mattbrejza/cubesat-comms/testing/pa/b.png

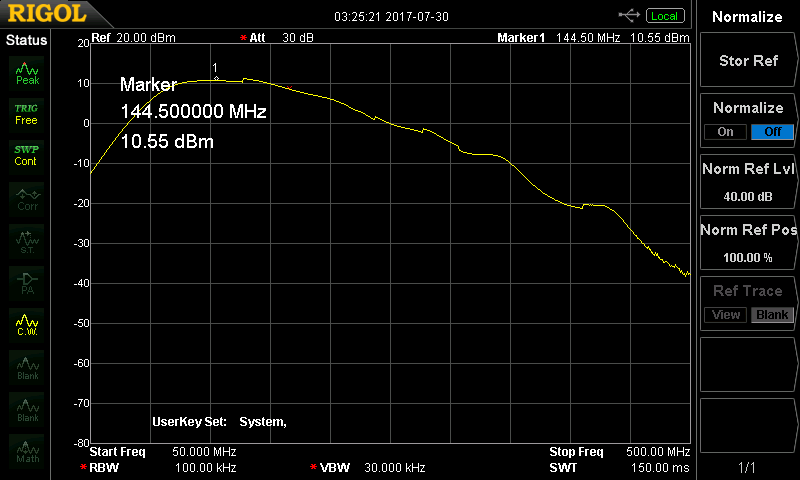
testing/pa/b.png
