mattbrejza/cubesat-comms/testing/pa/r.png

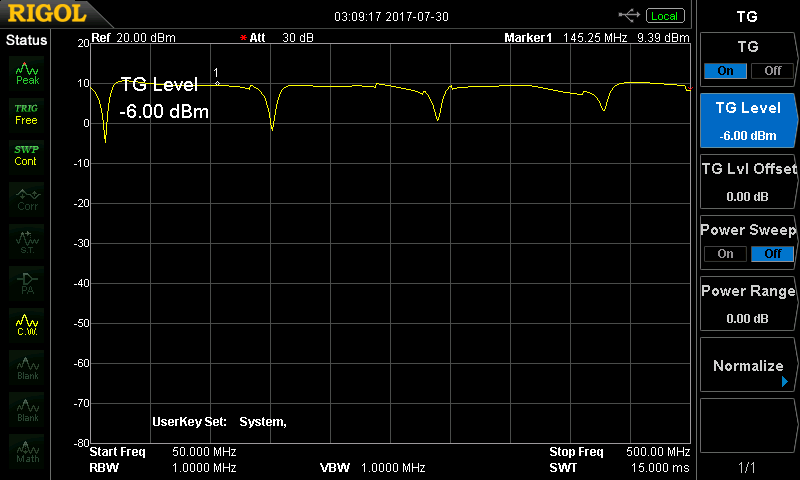
testing/pa/r.png
