mattbrejza/cubesat-comms/testing/pa/tek00002.png

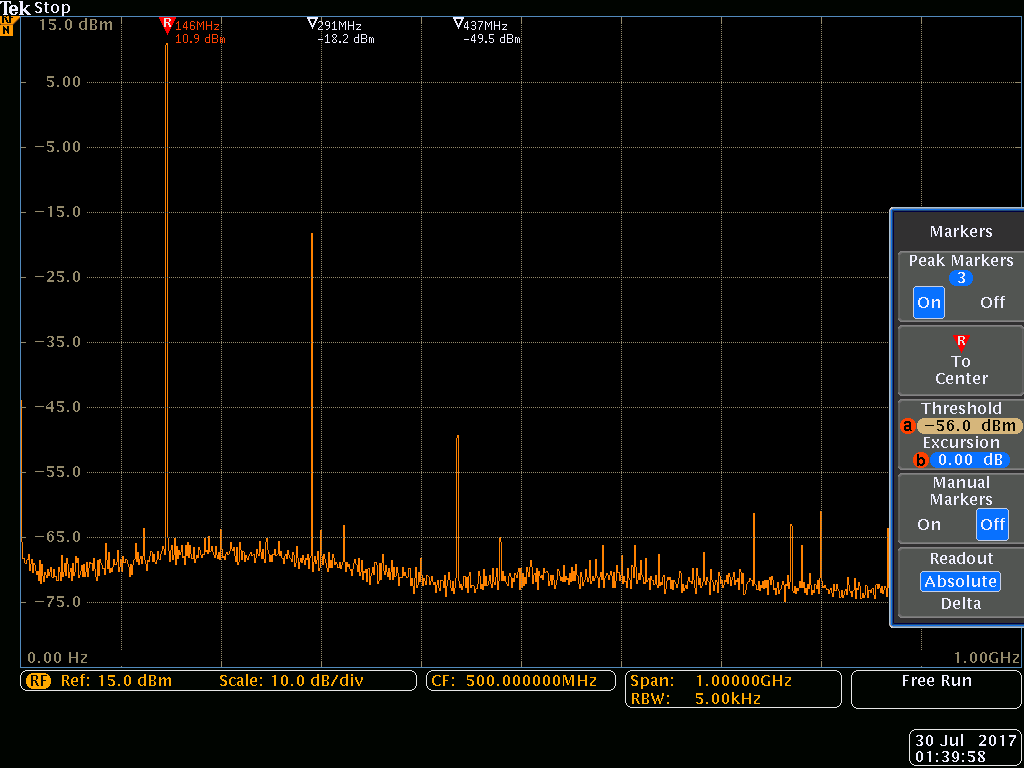
testing/pa/tek00002.png
