mattbrejza/cubesat-comms/testing/pa/tek00003.png

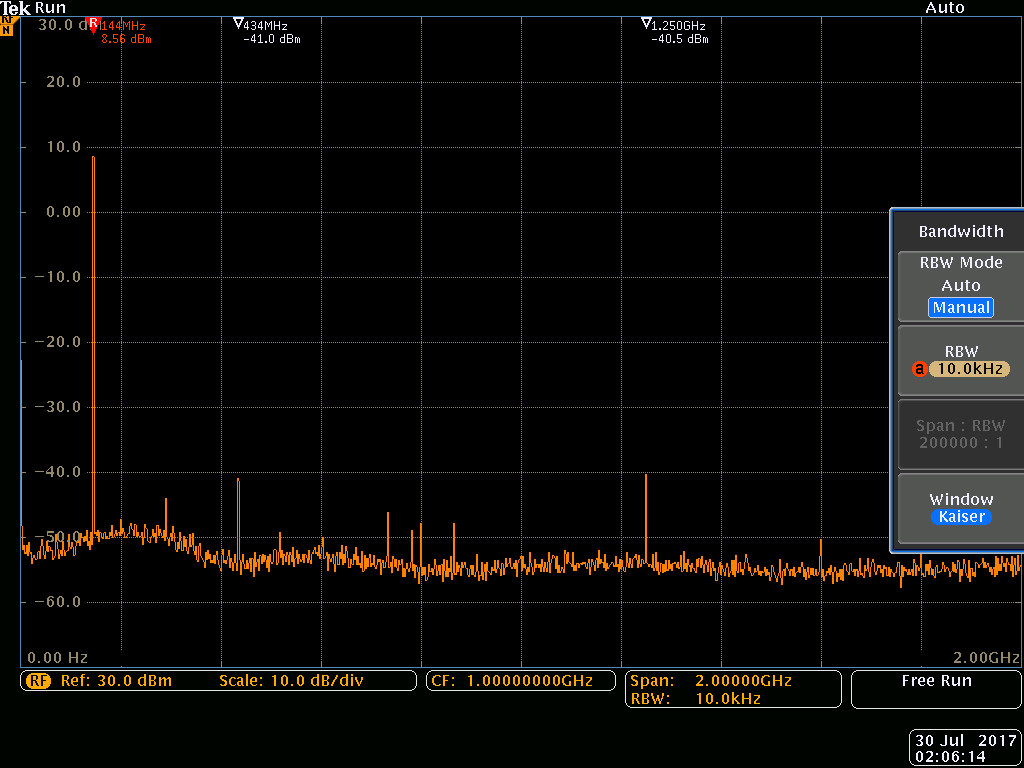
testing/pa/tek00003.png
