mattbrejza/cubesat-comms/testing/pa/tek00004.png

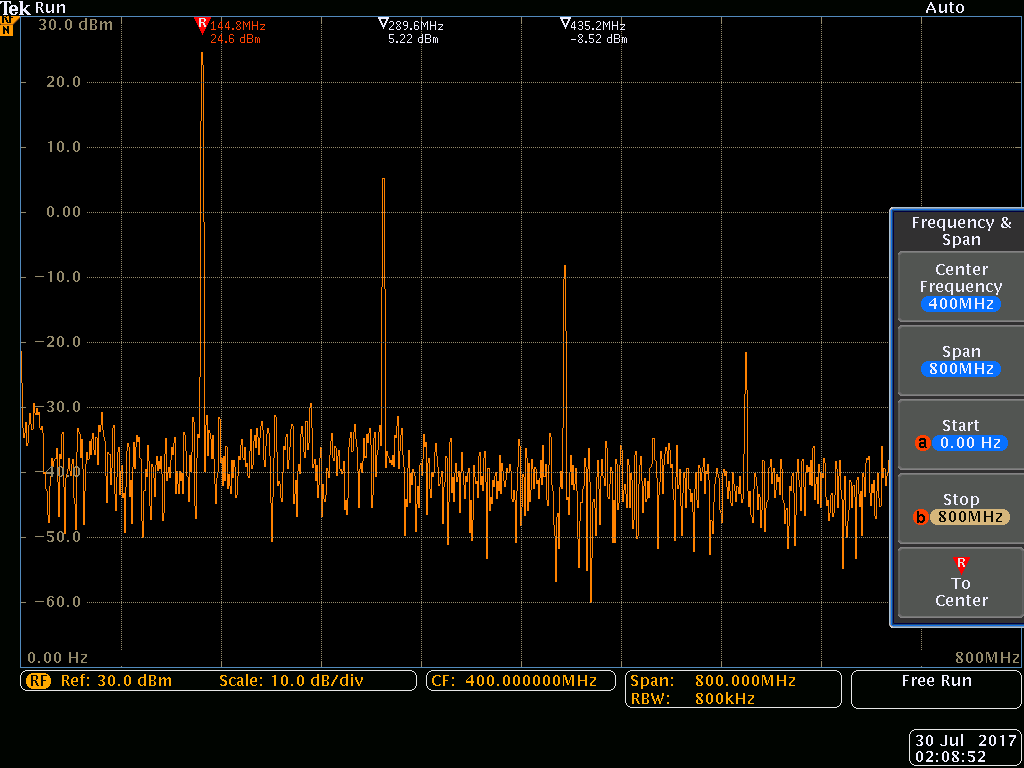
testing/pa/tek00004.png
