mattbrejza/cubesat-comms/testing/pa/tek00005.png

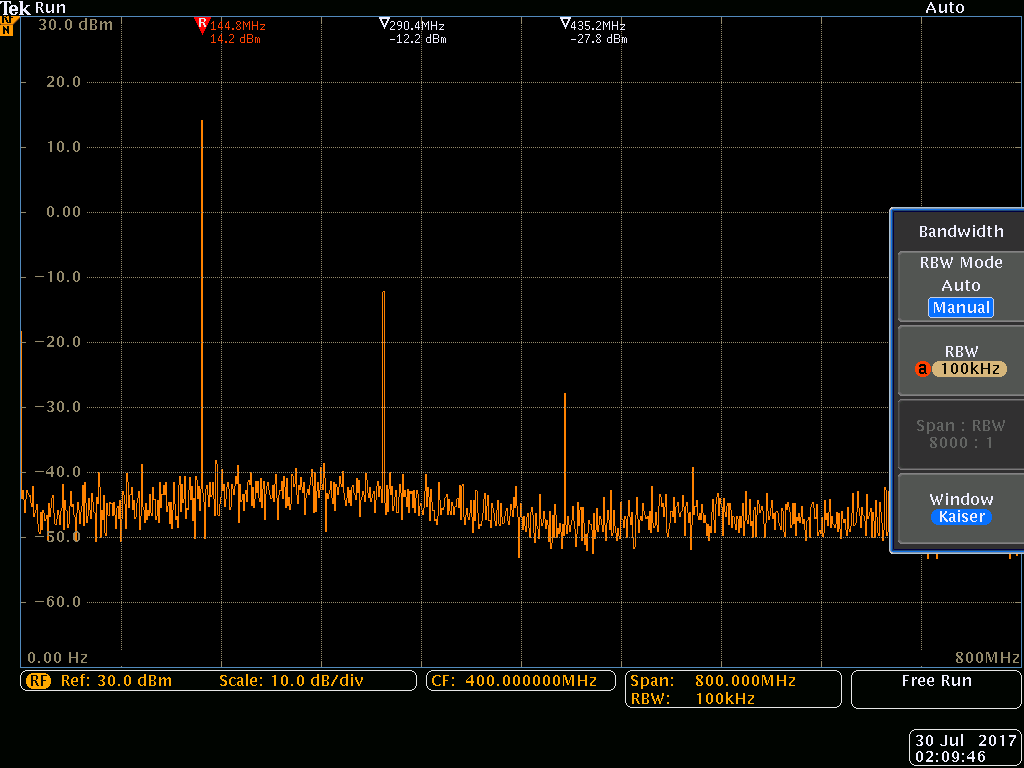
testing/pa/tek00005.png
