mattbrejza/cubesat-comms/testing/pa/tek00006.png

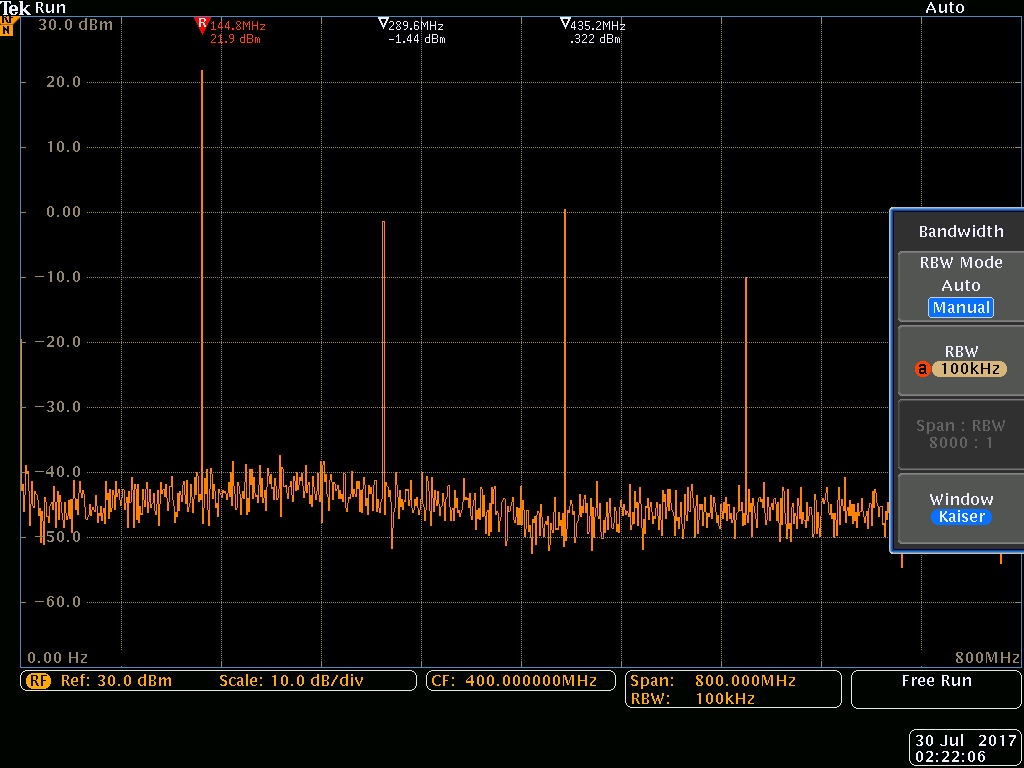
testing/pa/tek00006.png
