mattbrejza/cubesat-comms/testing/pa/tek00007.png

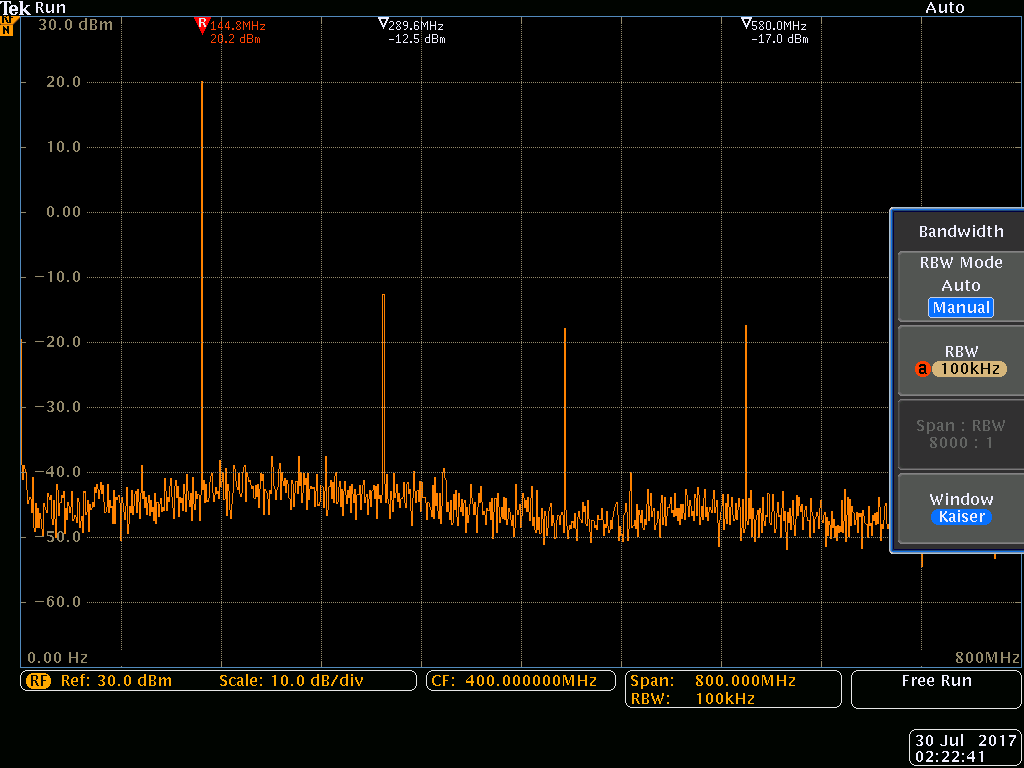
testing/pa/tek00007.png
