mattbrejza/cubesat-comms/testing/pa/w.png

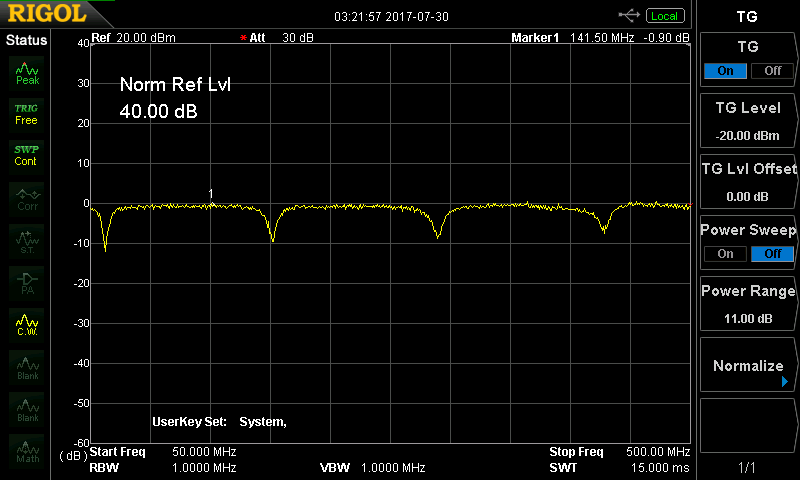
testing/pa/w.png
