mattbrejza/cubesat-comms/paper-fig.pdf

# Supervisor circuit

5V

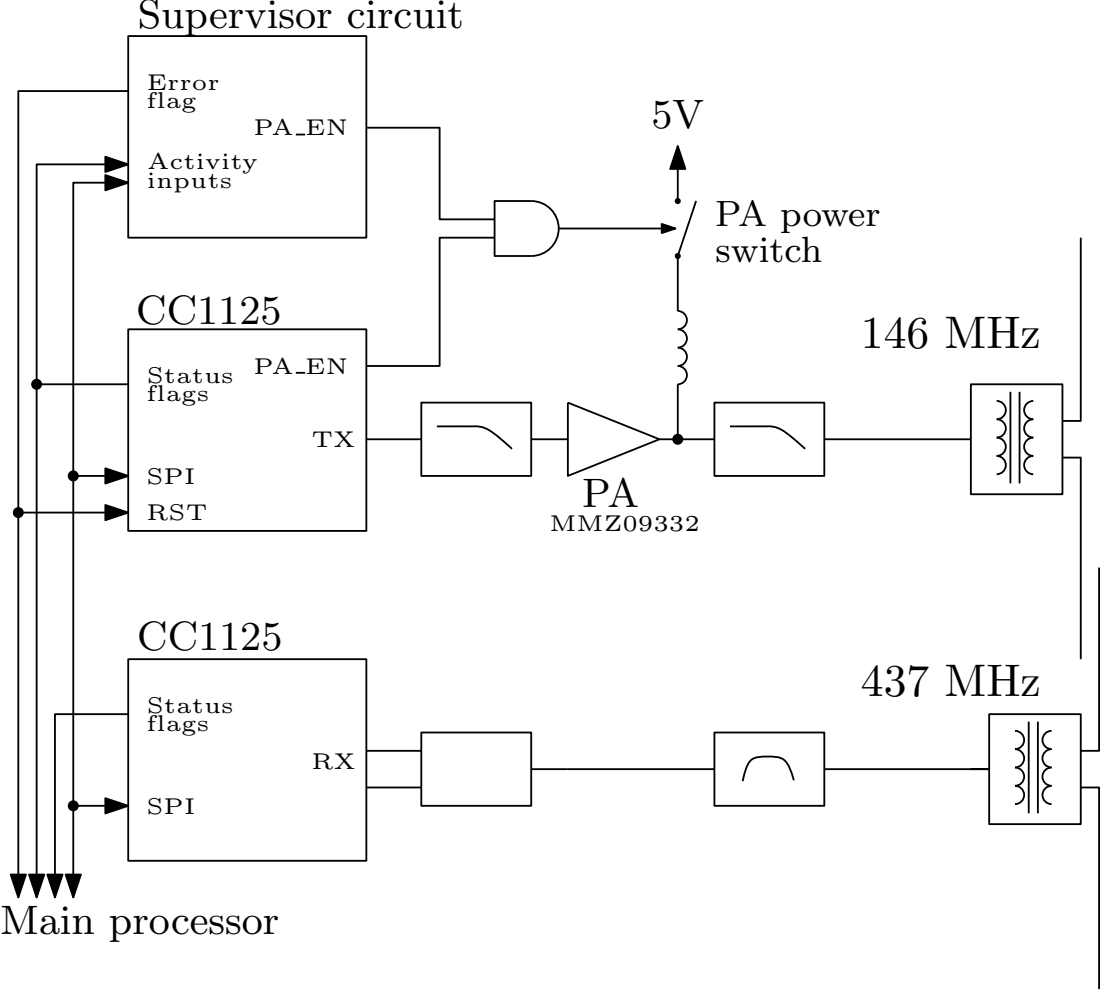
[picture p10: page 1]
146 MHz; 437 MHz; SPI; MMZ09332; Status flags; Error flag; Activity inputs; PA power switch; Main processor; RST
