mattbrejza/cubesat-comms/board-fc-cm/fc-comms-2.brd

## EAGLE design board-fc-cm/fc-comms-2.brd (2018-10-24)

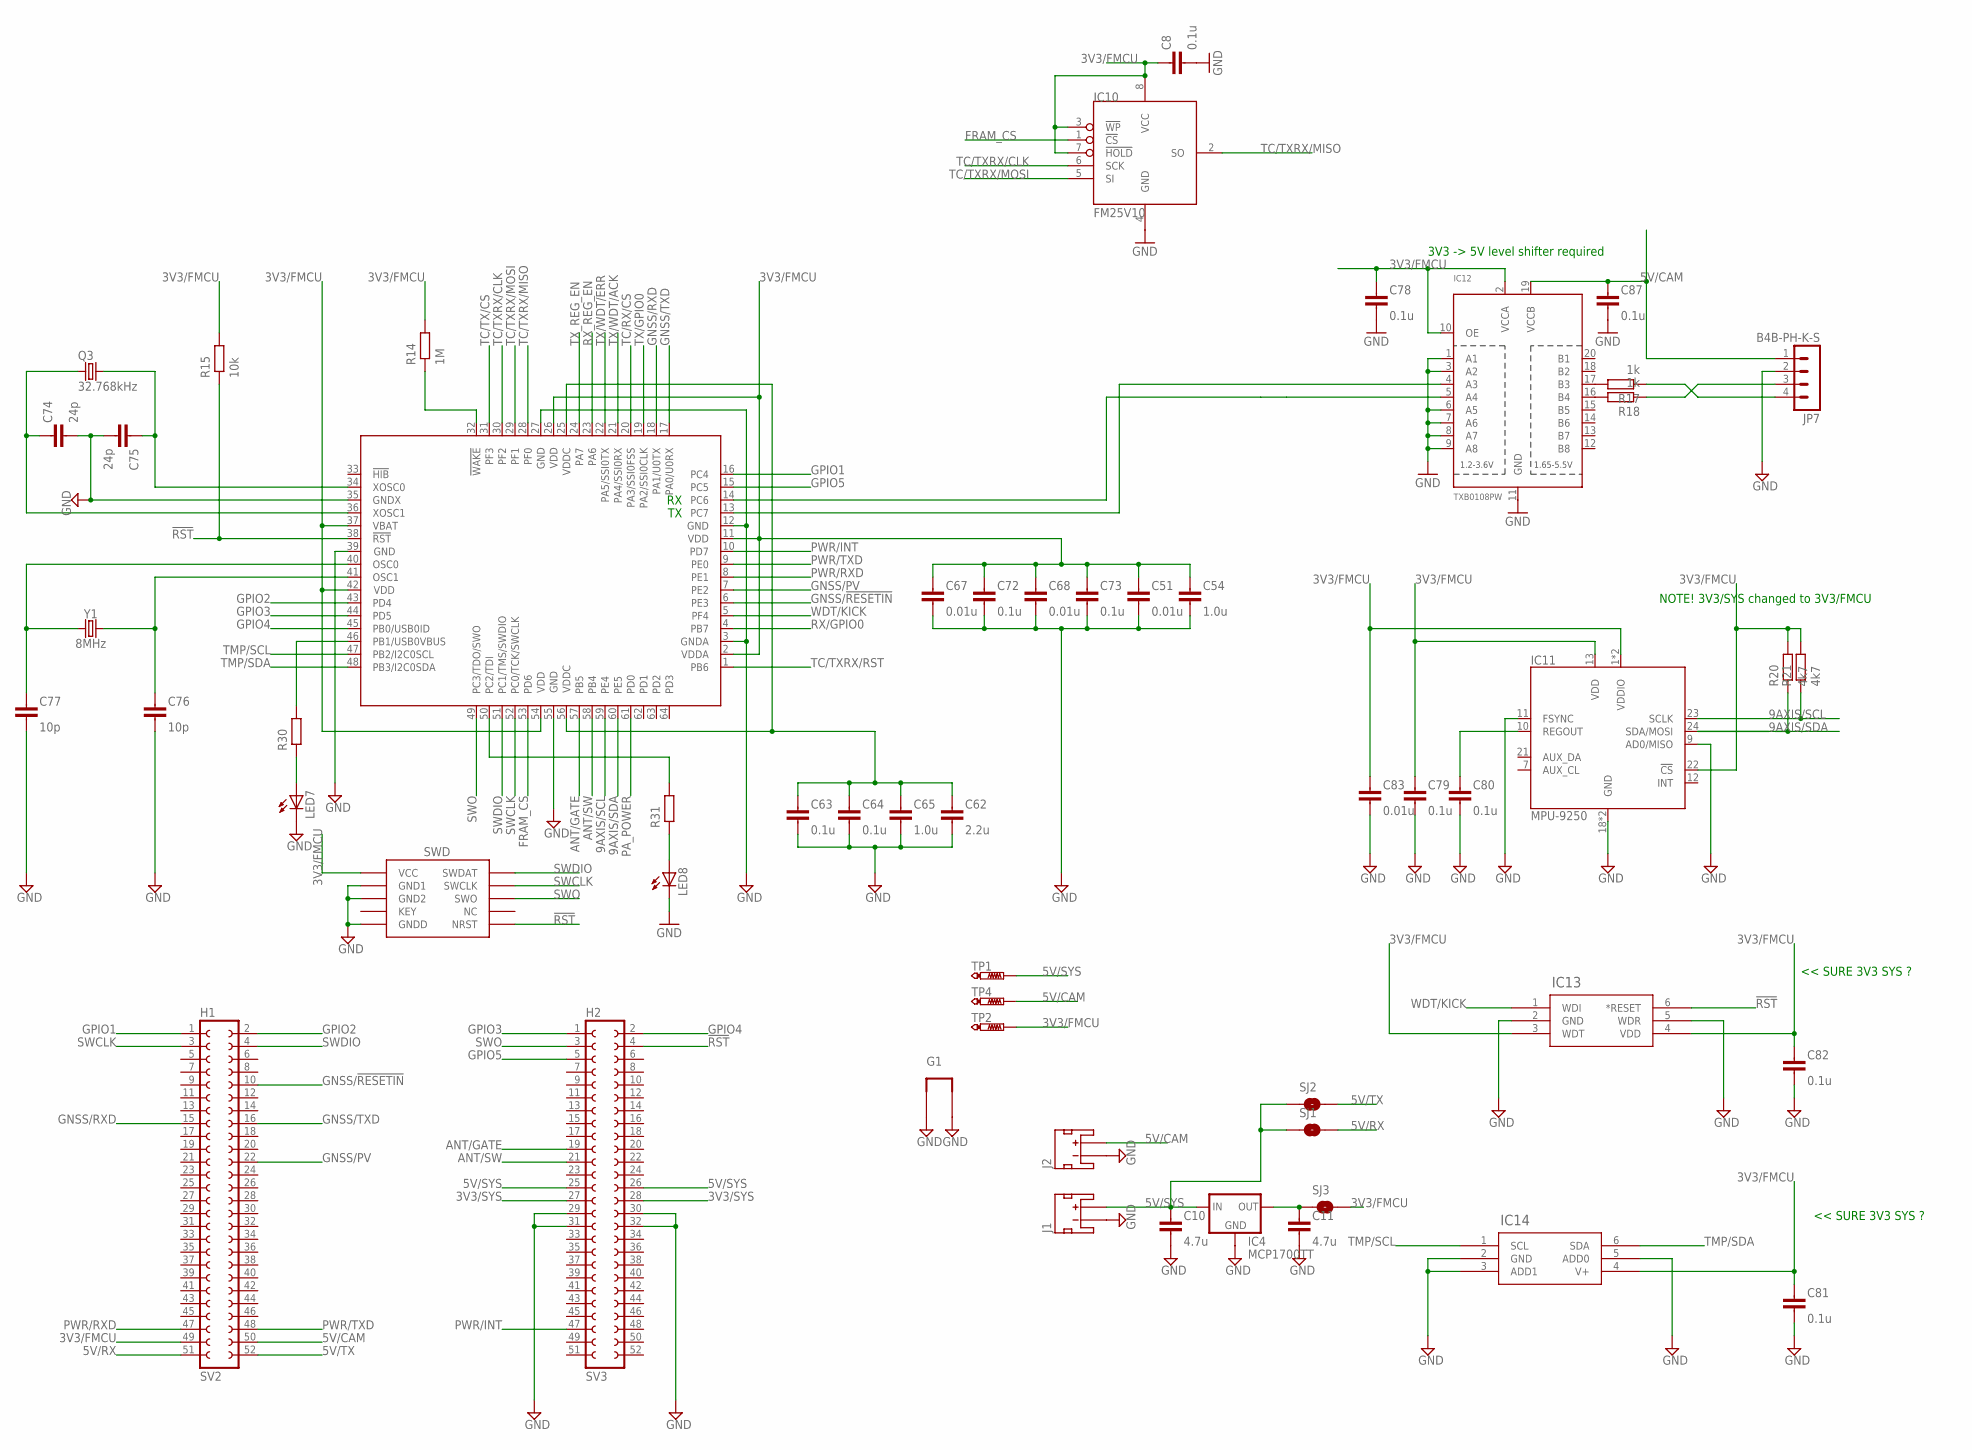
[picture p11: schematic fc-comms-2.sch, sheet 1]

Parts:
C8, C63, C64, C72, C73, C78, C79, C80, C81, C82, C87: 0.1u; C0603-N
C10, C11: 4.7u; C0603-N
C51, C67, C68, C83: 0.01u; C0603-N
C54, C65: 1.0u; C0603-N
C62: 2.2u; C0603-N
C74, C75: 24p; C0603-N
C76, C77: 10p; C0603-N
G1: GND-LOOPL; GND-LOOP-0.4
IC4: MCP1700TT; SOT23
IC9: TM4C123[7,G]XXPM; PM_S-PQFP-G64
IC10: FM25V10; SO-08M
IC11: MPU-9250; QFN-24/3MM
IC12: TXB0108PW; TSSOP20
IC13: TPS3813K33-EP_DBV_6; DBV6
IC14: TMP100-EP_DBV_6; DBV6
J1, J2: JST_2MM_MALE_TH; JST-2-TH
J3: SWD_SHROUD; SWD_PTH_SHROUD
JP7: B4B-PH-K-S
LED7, LED8: LEDCHIP-LED0603; CHIP-LED0603
Q3: 32.768kHz; RESONATOR_EPSON_FC_145; FARNELL 2101347
R14: 1M; R0603-N
R15: 10k; R0603-N
R17, R18: 1k; R0603-N
R20, R21: 4k7; R0603-N
R30, R31: RESISTOR0603-N; R0603-N
SJ1, SJ2, SJ3: JUMPER-PAD-2-NOYES_SILK; PAD-JUMPER-2-NO_YES_SILK
SV2: H1; FE26-2
SV3: H2; FE26-2
TP1, TP2, TP4: PTR1PAD1-13; P1-13
Y1: 8MHz; CRYSTAL-SMD-5X3.2-4PAD; FARNELL 2308726

Connections:
3V3/FMCU: C8.1, C51.1, C54.1, C67.1, C68.1, C72.1, C73.1, C78.1, C79.1, C81.1, C82.1, C83.1, IC9.2 (VDDA), IC9.11 (VDD), IC9.26 (VDD), IC9.37 (VBAT), IC9.42 (VDD), IC9.54 (VDD), IC10.3 (!WP), IC10.7 (!HOLD), IC10.8 (VCC), IC11.1 (VDDIO), IC11.8 (VDDIO), IC11.13 (VDD), IC11.22 (!CS), IC12.2 (VCCA), IC12.10 (OE), IC13.3 (WDT), IC13.4 (VDD), IC14.4 (V+), J3.1 (VCC), R14.2, R15.2, R20.2, R21.2, SJ3.2, SV2.49, TP2.TP; also elsewhere on the board
3V3/SYS: SV3.27, SV3.28
5V/CAM: C87.1, IC12.19 (VCCB), J2.1 (+), JP7.1, SV2.50, TP4.TP
5V/RX: SJ1.2, SV2.51; also elsewhere on the board
5V/SYS: C10.1, IC4.3 (IN), J1.1 (+), SJ1.1, SJ2.1, SV3.25, SV3.26, TP1.TP
5V/TX: SJ2.2, SV2.52; also elsewhere on the board
9AXIS/SCL: IC9.59 (PE4), IC11.23 (SCLK), R21.1
9AXIS/SDA: IC9.60 (PE5), IC11.24 (SDA/MOSI), R20.1
!RST: IC9.38 (!RST), IC13.6 (*RESET), J3.10 (NRST), R15.1, SV3.4
!WAKE: IC9.32 (!WAKE), R14.1
ANT/GATE: IC9.57 (PB5), SV3.19
ANT/SW: IC9.58 (PB4), SV3.21
CAM/RXD: IC9.13 (PC7), IC12.4 (A3)
CAM/TXD: IC9.14 (PC6), IC12.5 (A4)
FRAM_CS: IC9.53 (PD6), IC10.1 (!CS)
GND: C8.2, C10.2, C11.2, C51.2, C54.2, C62.2, C63.2, C64.2, C65.2, C67.2, C68.2, C72.2, C73.2, C74.2, C75.2, C76.2, C77.2, C78.2, C79.2, C80.2, C81.2, C82.2, C83.2, C87.2, G1.P$3 (1), G1.P$4 (2), IC4.1 (GND), IC9.3 (GNDA), IC9.12 (GND), IC9.27 (GND), IC9.35 (GNDX), IC9.39 (GND), IC9.55 (GND), IC10.4 (GND), IC11.9 (AD0/MISO), IC11.11 (FSYNC), IC11.18 (GND), IC11.20 (GND), IC12.1 (A1), IC12.3 (A2), IC12.6 (A5), IC12.7 (A6), IC12.8 (A7), IC12.9 (A8), IC12.11 (GND), IC13.2 (GND), IC13.5 (WDR), IC14.2 (GND), IC14.3 (ADD1), IC14.5 (ADD0), J1.2 (-), J2.2 (-), J3.3 (GND1), J3.5 (GND2), J3.9 (GNDD), JP7.2, LED7.C, LED8.C, SV3.29, SV3.30, SV3.31, SV3.32; also elsewhere on the board
GNSS/!RESETIN: IC9.6 (PE3), SV2.10
GNSS/PV: IC9.7 (PE2), SV2.22
GNSS/RXD: IC9.18 (PA1/U0TX), SV2.15
GNSS/TXD: IC9.17 (PA0/U0RX), SV2.16
GPIO1: IC9.16 (PC4), SV2.1
GPIO2: IC9.43 (PD4), SV2.2
GPIO3: IC9.44 (PD5), SV3.1
GPIO4: IC9.45 (PB0/USB0ID), SV3.2
GPIO5: IC9.15 (PC5), SV3.5
unnamed: C80.1, IC11.10 (REGOUT)
unnamed: C62.1, C63.1, C64.1, C65.1, IC9.25 (VDDC), IC9.56 (VDDC)
unnamed: C75.1, IC9.34 (XOSC0), Q3.P$2 (2)
unnamed: C77.1, IC9.40 (OSC0), Y1.1
unnamed: JP7.3, R18.1
unnamed: JP7.4, R17.1
unnamed: C76.1, IC9.41 (OSC1), Y1.3 (2)
unnamed: C74.1, IC9.36 (XOSC1), Q3.P$1 (1)
unnamed: LED7.A, R30.1
unnamed: LED8.A, R31.1
unnamed: IC9.50 (PC2/TDI), R31.2
unnamed: IC12.17 (B3), R17.2
unnamed: IC9.46 (PB1/USB0VBUS), R30.2
unnamed: IC12.16 (B4), R18.2
unnamed: C11.1, IC4.2 (OUT), SJ3.1
PA_POWER: IC9.61 (PD0); also elsewhere on the board
PWR/INT: IC9.10 (PD7), SV3.47
PWR/RXD: IC9.8 (PE1), SV2.47
PWR/TXD: IC9.9 (PE0), SV2.48
RX/GPIO0: IC9.4 (PB7); also elsewhere on the board
RX_REG_EN: IC9.23 (PA6); also elsewhere on the board
SWCLK: IC9.52 (PC0/TCK/SWCLK), J3.4 (SWCLK), SV2.3
SWDIO: IC9.51 (PC1/TMS/SWDIO), J3.2 (SWDAT), SV2.4
SWO: IC9.49 (PC3/TDO/SWO), J3.6 (SWO), SV3.3
TC/RX/CS: IC9.20 (PA3/SSI0FSS); also elsewhere on the board
TC/TX/CS: IC9.31 (PF3); also elsewhere on the board
TC/TXRX/CLK: IC9.30 (PF2), IC10.6 (SCK); also elsewhere on the board
TC/TXRX/MISO: IC9.28 (PF0), IC10.2 (SO); also elsewhere on the board
TC/TXRX/MOSI: IC9.29 (PF1), IC10.5 (SI); also elsewhere on the board
TC/TXRX/RST: IC9.1 (PB6); also elsewhere on the board
TMP/SCL: IC9.47 (PB2/I2C0SCL), IC14.1 (SCL); also elsewhere on the board
TMP/SDA: IC9.48 (PB3/I2C0SDA), IC14.6 (SDA); also elsewhere on the board
TX/GPIO0: IC9.19 (PA2/SSI0CLK); also elsewhere on the board
TX/WDT/ACK: IC9.21 (PA4/SSI0RX); also elsewhere on the board
TX/WDT/ERR: IC9.22 (PA5/SSI0TX); also elsewhere on the board
TX_REG_EN: IC9.24 (PA7); also elsewhere on the board
WDT/KICK: IC9.5 (PF4), IC13.1 (WDI)

Notes on the sheet:
3V3 -> 5V level shifter required
<< SURE 3V3 SYS ?
NOTE! 3V3/SYS changed to 3V3/FMCU

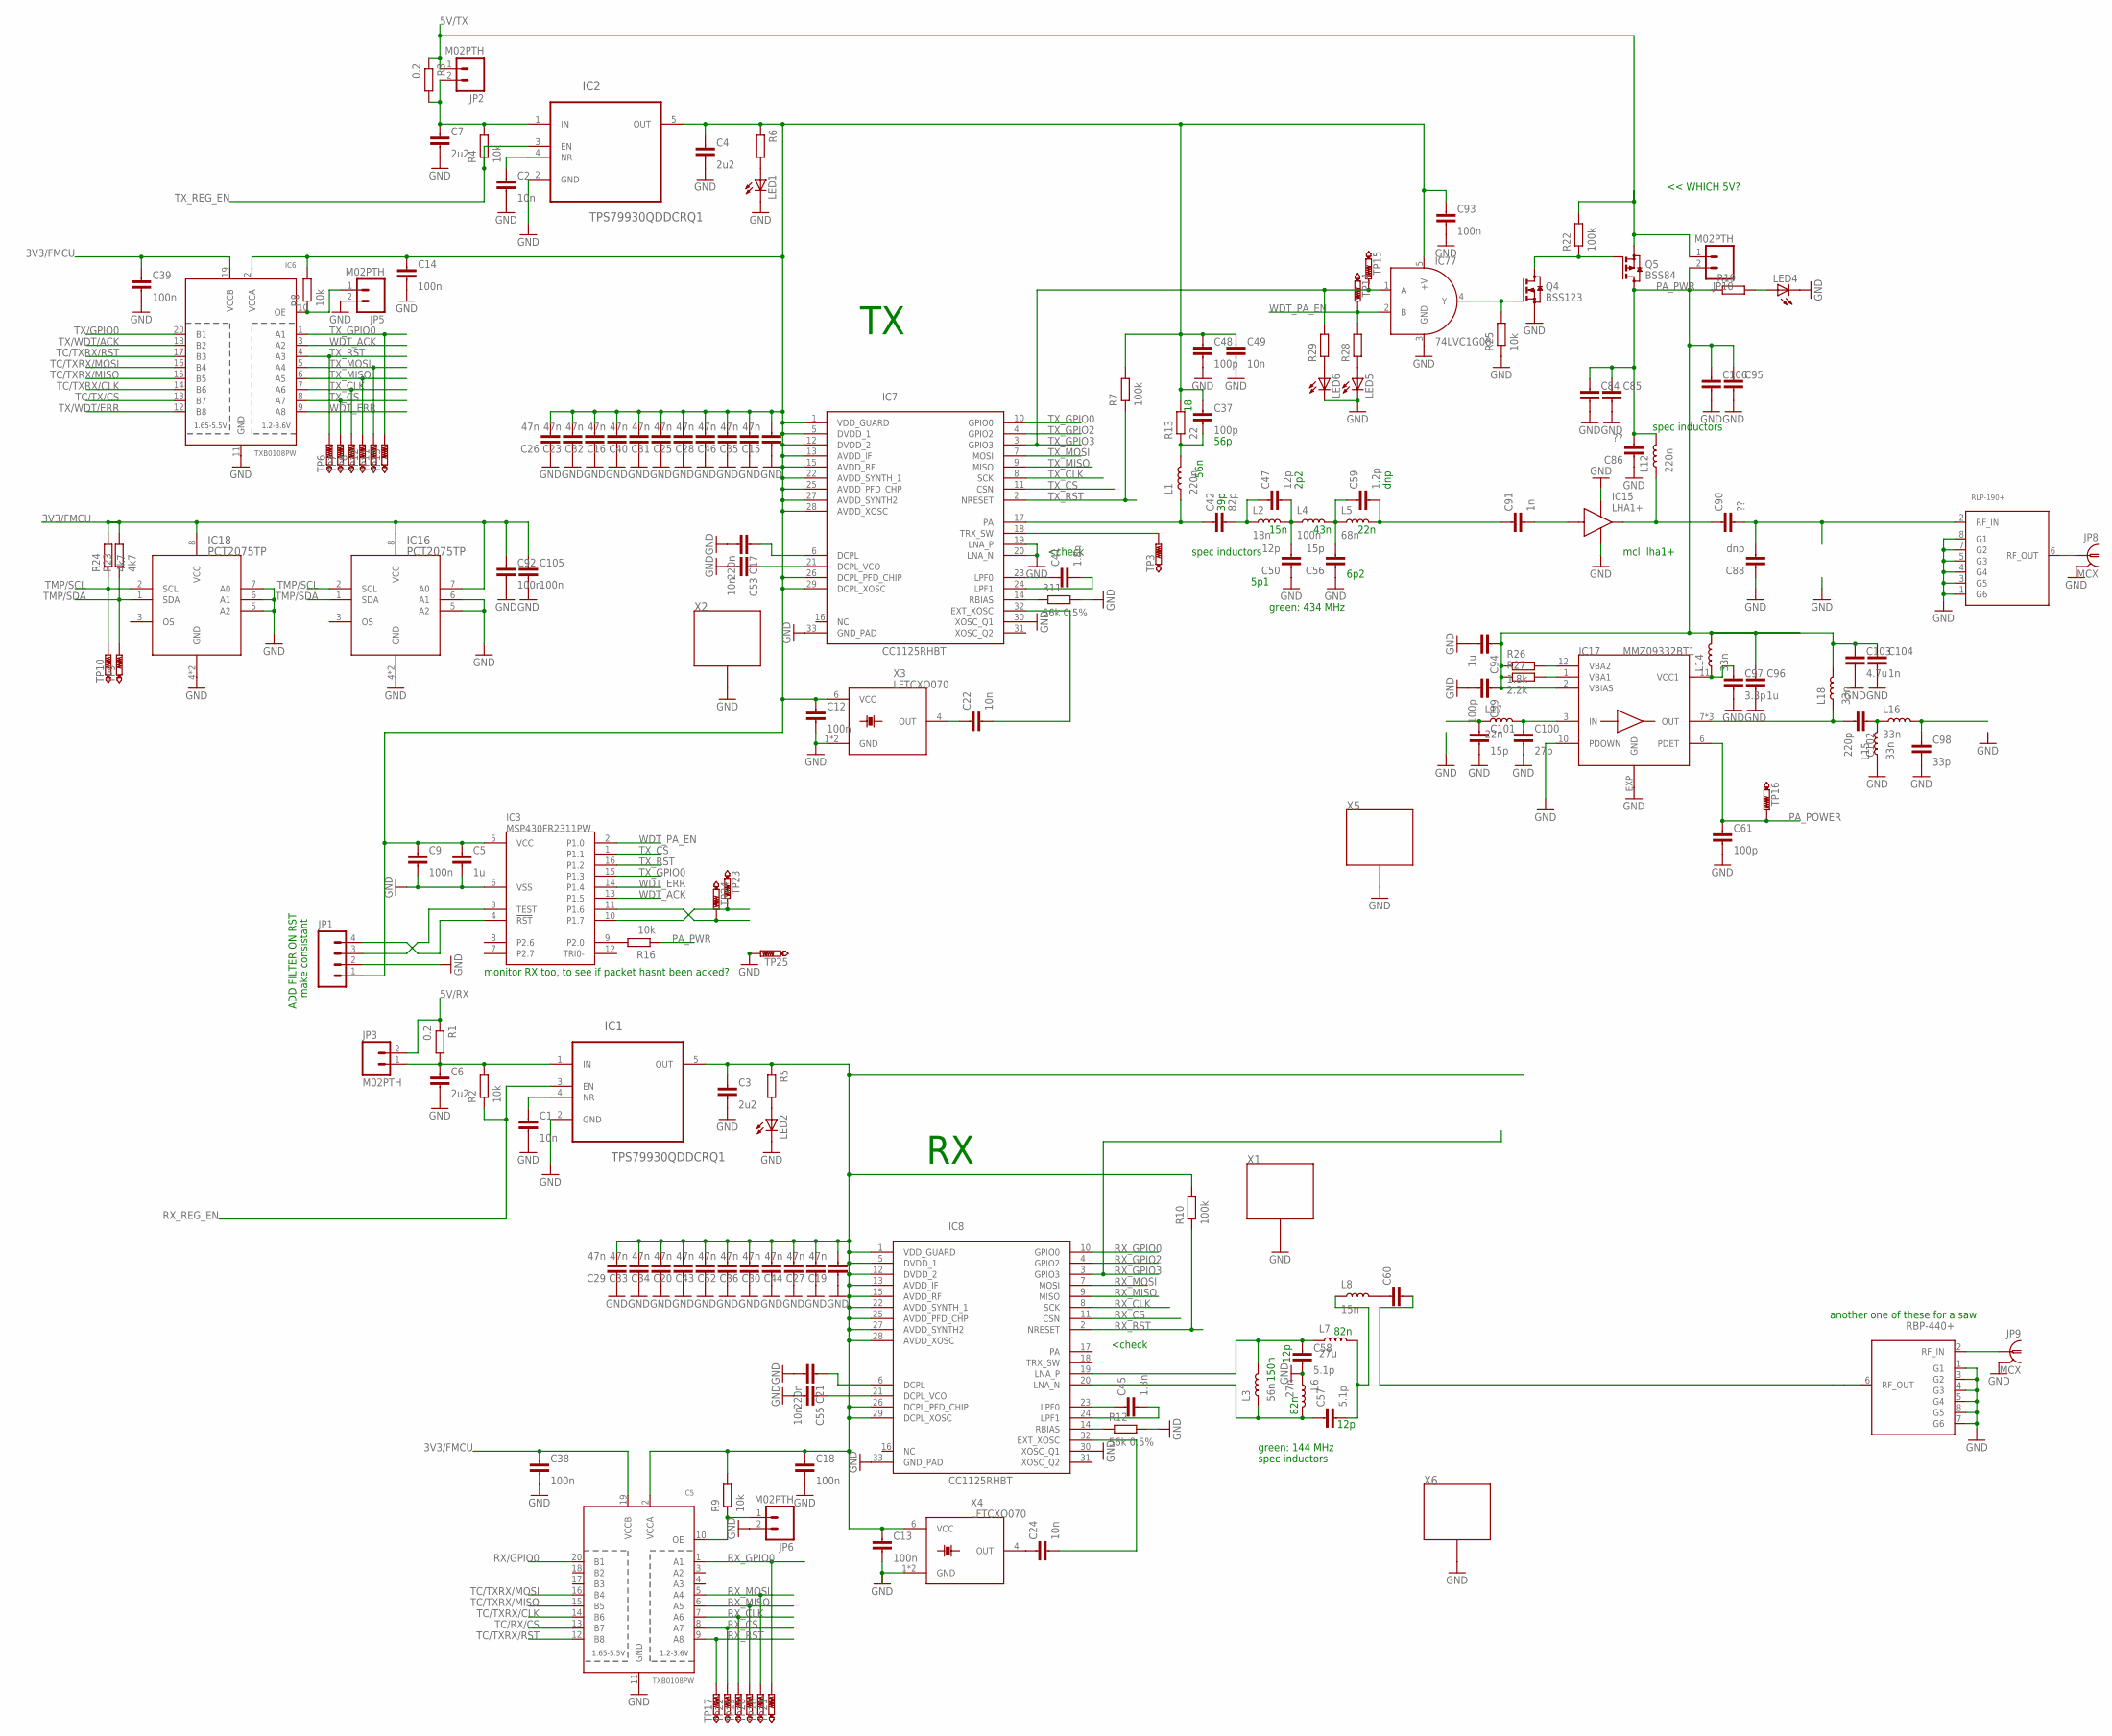
[picture p12: schematic fc-comms-2.sch, sheet 2]

Parts:
C1, C2, C22, C24, C49, C53, C55: 10n; C0603-N
C3, C4, C6, C7: 2u2; C0603-N
C5, C94, C96: 1u; C0603-N
C9, C12, C13, C14, C18, C38, C39, C92, C93, C105: 100n; C0603-N
C15, C16, C19, C20, C23, C25, C26, C27, C28, C29, C30, C31, C32, C33, C34, C35, C36, C40, C43, C44, C46, C52: 47n; C0603-N
C17, C21: 220n; C0603-N
C37, C48, C61, C99: 100p; C0603-N
C41, C45: 1.8n; C0603-N
C42: 82p; C0603-N
C47, C50: 12p; C0603-N
C56, C101: 15p; C0603-N
C57, C58: 5.1p; C0603-N
C59: 1.2p; C0603-N
C60: CAPACITOR0603-N; C0603-N
C84, C85, C95, C106: CAPACITOR0805-N; C0805-N
C86, C90: ??; C0603-N
C88: dnp; C0603-N
C91, C104: 1n; C0603-N
C97: 3.3p; C0603-N
C98: 33p; C0603-N
C100: 27p; C0603-N
C102: 220p; C0603-N
C103: 4.7u; C0603-N
FL2: SAW_FILTER_CS; PL-176
FL3: LPF_CS; PL-176
IC1, IC2: TPS79930QDDCRQ1; SOT95P280X110-5N
IC3: MSP430FR2311PW; SSOP16
IC5, IC6: TXB0108PW; TSSOP20
IC7, IC8: CC1125RHBT; QFN32_5X5
IC15: LHA1+; PA
IC16, IC18: PCT2075TP; HWSON8
IC17: MMZ09332BT1; QFN3X3-6
IC77: 74LVC1G08; SOT23-5
JP1: M04PTH; 1X04
JP2, JP3, JP5, JP6, JP10: M02PTH; 1X02
JP8, JP9: MCX; MCX-STRAIGHT
L1, L12: 220n; L0603-N
L2: 18n; L0603-N
L3: 56n; L0603-N
L4: 100n; L0603-N
L5: 68n; L0603-N
L6: 27n; L0603-N
L7: 27u; L0603-N
L8: 15n; L0603-N
L14, L15, L16, L18: 33n; L0603-N
L17: 22n; L0603-N
LED1, LED2, LED4, LED5, LED6: LEDCHIP-LED0603; CHIP-LED0603
Q4: BSS123; SOT23
Q5: BSS84; SOT23
R1, R3: 0.2; R0603-N
R2, R4, R8, R9, R16, R25: 10k; R0603-N
R5, R6, R19, R28, R29: RESISTOR0603-N; R0603-N
R7, R10, R22: 100k; R0603-N
R11, R12: 56k 0.5%; R0603-N
R13: 22; R0603-N
R23, R24: 4k7; R0603-N
R26: 1.8k; R0603-N
R27: 2.2k; R0603-N
TP3, TP6, TP7, TP8, TP9, TP10, TP11, TP12, TP13, TP14, TP15, TP16, TP17, TP18, TP19, TP20, TP21, TP22, TP23, TP24, TP25: PTR1B1,27; B1,27
X1, X2, X5, X6: SHIELD-26X26
X3, X4: LFTCXO070; 260-SERIES

Connections:
3V3/FMCU: C38.1, C39.1, C92.1, C105.1, IC5.19 (VCCB), IC6.19 (VCCB), IC16.7 (A0), IC16.8 (VCC), IC18.8 (VCC), R23.2, R24.2; also elsewhere on the board
5V/RX: JP3.2, R1.1; also elsewhere on the board
5V/TX: JP2.1, JP10.1, Q5.2 (S), R3.1, R22.2; also elsewhere on the board
EWFEWF: C6.1, IC1.1 (IN), JP3.1, R1.2, R2.2
GND: C1.2, C2.2, C3.2, C4.2, C5.2, C6.2, C7.2, C9.2, C12.2, C13.2, C14.2, C15.1, C16.1, C17.2, C18.2, C19.1, C20.1, C21.2, C23.1, C25.1, C26.1, C27.1, C28.1, C29.1, C30.1, C31.1, C32.1, C33.1, C34.1, C35.1, C36.1, C38.2, C39.2, C40.1, C43.1, C44.1, C46.1, C48.2, C49.2, C50.1, C52.1, C53.2, C55.2, C56.1, C58.2, C61.2, C84.2, C85.2, C86.1, C88.1, C92.2, C93.2, C94.2, C95.2, C96.2, C97.2, C98.2, C99.2, C100.2, C101.2, C103.2, C104.2, C105.2, C106.2, FL2.1 (G1), FL2.3 (G2), FL2.4 (G3), FL2.5 (G4), FL2.7 (G6), FL2.8 (G5), FL3.1 (G6), FL3.3 (G5), FL3.4 (G4), FL3.5 (G3), FL3.7 (G2), FL3.8 (G1), IC1.2 (GND), IC2.2 (GND), IC3.6 (VSS), IC5.11 (GND), IC6.11 (GND), IC7.19 (LNA_P), IC7.20 (LNA_N), IC7.30 (XOSC_Q1), IC7.33 (GND_PAD), IC8.30 (XOSC_Q1), IC8.33 (GND_PAD), IC15.GND1, IC15.GND2, IC16.4 (GND), IC16.5 (A2), IC16.6 (A1), IC16.EP (GND), IC17.10 (PDOWN), IC17.EXP (GND), IC18.4 (GND), IC18.5 (A2), IC18.6 (A1), IC18.7 (A0), IC18.EP (GND), IC77.3 (GND), JP1.2, JP5.2, JP6.2, JP8.P$2 (2), JP8.P$3 (2), JP8.P$4 (2), JP8.P$5 (2), JP9.P$2 (2), JP9.P$3 (2), JP9.P$4 (2), JP9.P$5 (2), L6.1, L15.1, LED1.C, LED2.C, LED4.C, LED5.C, LED6.C, Q4.2 (S), R11.2, R12.2, R25.1, TP25.TP, X1.G1, X1.G2, X1.G3, X1.G4, X1.G5, X1.G6, X1.G7, X1.G8, X1.G9, X1.G10, X1.G11, X1.G12, X1.G13, X1.G14, X1.G15, X1.G16, X1.G17, X1.G19, X1.G20, X1.G21, X2.G1, X2.G2, X2.G3, X2.G4, X2.G5, X2.G6, X2.G7, X2.G8, X2.G9, X2.G10, X2.G11, X2.G12, X2.G13, X2.G14, X2.G15, X2.G16, X2.G17, X2.G19, X2.G20, X2.G21, X3.1 (GND), X3.3 (GND), X4.1 (GND), X4.3 (GND), X5.G1, X5.G2, X5.G3, X5.G4, X5.G5, X5.G6, X5.G7, X5.G8, X5.G9, X5.G10, X5.G11, X5.G12, X5.G13, X5.G14, X5.G15, X5.G16, X5.G17, X5.G19, X5.G20, X5.G21, X6.G1, X6.G2, X6.G3, X6.G4, X6.G5, X6.G6, X6.G7, X6.G8, X6.G9, X6.G10, X6.G11, X6.G12, X6.G13, X6.G14, X6.G15, X6.G16, X6.G17, X6.G19, X6.G20, X6.G21; also elsewhere on the board
unnamed: IC3.9 (P2.0), R16.2
unnamed: C41.1, IC7.23 (LPF0)
unnamed: C41.2, IC7.24 (LPF1)
unnamed: LED5.A, R28.1
unnamed: C53.1, IC7.21 (DCPL_VCO)
unnamed: C42.1, IC7.17 (PA), L1.1
unnamed: IC7.14 (RBIAS), R11.1
unnamed: C22.2, IC7.32 (EXT_XOSC)
unnamed: C37.2, L1.2, R13.1
unnamed: C91.2, IC15.RF_IN
unnamed: C90.1, IC15.RF_OUT, L12.1
unnamed: C17.1, IC7.6 (DCPL)
unnamed: C42.2, C47.1, L2.1
unnamed: C47.2, C50.2, L2.2, L4.1
unnamed: C56.2, C59.1, L4.2, L5.1
unnamed: C59.2, C91.1, L5.2
unnamed: LED6.A, R29.1
unnamed: C88.2, C90.2, FL3.2 (RF_IN)
unnamed: FL3.6 (RF_OUT), JP8.P$1 (1)
unnamed: C45.1, IC8.23 (LPF0)
unnamed: C45.2, IC8.24 (LPF1)
unnamed: C55.1, IC8.21 (DCPL_VCO)
unnamed: IC8.14 (RBIAS), R12.1
unnamed: C24.2, IC8.32 (EXT_XOSC)
unnamed: LED4.A, R19.2
unnamed: IC7.18 (TRX_SW), TP3.TP
unnamed: C4.1, C5.1, C9.1, C12.1, C14.1, C15.2, C16.2, C23.2, C25.2, C26.2, C28.2, C31.2, C32.2, C35.2, C37.1, C40.2, C46.2, C48.1, C49.1, C93.1, IC2.5 (OUT), IC3.5 (VCC), IC6.2 (VCCA), IC7.1 (VDD_GUARD), IC7.5 (DVDD_1), IC7.12 (DVDD_2), IC7.13 (AVDD_IF), IC7.15 (AVDD_RF), IC7.22 (AVDD_SYNTH_1), IC7.25 (AVDD_PFD_CHP), IC7.26 (DCPL_PFD_CHIP), IC7.27 (AVDD_SYNTH2), IC7.28 (AVDD_XOSC), IC7.29 (DCPL_XOSC), IC77.5 (+V), JP1.1, R6.1, R7.2, R8.2, R13.2, X3.6 (VCC)
unnamed: LED1.A, R6.2
unnamed: C21.1, IC8.6 (DCPL)
unnamed: LED2.A, R5.2
unnamed: C58.1, IC8.19 (LNA_P), L3.2, L7.1
unnamed: C57.1, IC8.20 (LNA_N), L3.1, L6.2
unnamed: C3.1, C13.1, C18.1, C19.2, C20.2, C27.2, C29.2, C30.2, C33.2, C34.2, C36.2, C43.2, C44.2, C52.2, IC1.5 (OUT), IC5.2 (VCCA), IC8.1 (VDD_GUARD), IC8.5 (DVDD_1), IC8.12 (DVDD_2), IC8.13 (AVDD_IF), IC8.15 (AVDD_RF), IC8.22 (AVDD_SYNTH_1), IC8.25 (AVDD_PFD_CHP), IC8.26 (DCPL_PFD_CHIP), IC8.27 (AVDD_SYNTH2), IC8.28 (AVDD_XOSC), IC8.29 (DCPL_XOSC), R5.1, R9.2, R10.2, X4.6 (VCC)
unnamed: FL2.2 (RF_IN), JP9.P$1 (1)
unnamed: C60.2, FL2.6 (RF_OUT)
unnamed: C2.1, IC2.4 (NR)
unnamed: C1.1, IC1.4 (NR)
unnamed: Q4.3 (D), Q5.1 (G), R22.1
unnamed: C102.1, L15.2, L16.1
unnamed: C102.2, IC17.7 (OUT), IC17.8 (OUT), IC17.9 (OUT), L18.1
unnamed: C98.1, L16.2
unnamed: C97.1, IC17.11 (VCC1), L14.1
unnamed: IC17.12 (VBA2), R26.2
unnamed: IC17.1 (VBA1), R27.2
unnamed: C101.1, L17.1
unnamed: C100.1, IC17.3 (IN), L17.2
unnamed: C22.1, X3.4 (OUT)
unnamed: C24.1, X4.4 (OUT)
unnamed: IC3.3 (TEST), JP1.3
unnamed: IC3.4 (!RST), JP1.4
unnamed: IC3.11 (P1.6), TP24.TP
unnamed: IC3.10 (P1.7), TP23.TP
unnamed: C60.1, L8.2
unnamed: C57.2, L7.2, L8.1
unnamed: IC6.10 (OE), JP5.1, R8.1
unnamed: IC5.10 (OE), JP6.1, R9.1
unnamed: C7.1, IC2.1 (IN), JP2.2, R3.2, R4.2
unnamed: IC77.4 (Y), Q4.1 (G), R25.2
PA_POWER: C61.1, IC17.6 (PDET), TP16.TP; also elsewhere on the board
PA_PWR: C84.1, C85.1, C86.2, C94.1, C95.1, C96.1, C99.1, C103.1, C104.1, C106.1, IC17.2 (VBIAS), JP10.2, L12.2, L14.2, L18.2, Q5.3 (D), R16.1, R19.1, R26.1, R27.1
RX/GPIO0: IC5.20 (B1); also elsewhere on the board
RX_CLK: IC5.7 (A6), IC8.8 (SCK), TP19.TP
RX_CS: IC5.8 (A7), IC8.11 (CSN), TP22.TP
RX_GPIO0: IC5.1 (A1), IC8.10 (GPIO0), TP21.TP
RX_GPIO2: IC8.4 (GPIO2)
RX_GPIO3: IC8.3 (GPIO3)
RX_MISO: IC5.6 (A5), IC8.9 (MISO), TP20.TP
RX_MOSI: IC5.5 (A4), IC8.7 (MOSI), TP18.TP
RX_REG_EN: IC1.3 (EN), R2.1; also elsewhere on the board
RX_RST: IC5.9 (A8), IC8.2 (NRESET), R10.1, TP17.TP
TC/RX/CS: IC5.13 (B7); also elsewhere on the board
TC/TX/CS: IC6.13 (B7); also elsewhere on the board
TC/TXRX/CLK: IC5.14 (B6), IC6.14 (B6); also elsewhere on the board
TC/TXRX/MISO: IC5.15 (B5), IC6.15 (B5); also elsewhere on the board
TC/TXRX/MOSI: IC5.16 (B4), IC6.16 (B4); also elsewhere on the board
TC/TXRX/RST: IC5.12 (B8), IC6.17 (B3); also elsewhere on the board
TMP/SCL: IC16.2 (SCL), IC18.2 (SCL), R24.1, TP10.TP; also elsewhere on the board
TMP/SDA: IC16.1 (SDA), IC18.1 (SDA), R23.1, TP9.TP; also elsewhere on the board
TX/GPIO0: IC6.20 (B1); also elsewhere on the board
TX/WDT/ACK: IC6.18 (B2); also elsewhere on the board
TX/WDT/ERR: IC6.12 (B8); also elsewhere on the board
TX_CLK: IC6.7 (A6), IC7.8 (SCK), TP8.TP
TX_CS: IC3.1 (P1.1), IC6.8 (A7), IC7.11 (CSN), TP7.TP
TX_GPIO0: IC3.15 (P1.3), IC6.1 (A1), IC7.10 (GPIO0), TP13.TP
TX_GPIO2: IC7.4 (GPIO2)
TX_GPIO3: IC7.3 (GPIO3), IC77.1 (A), R29.2, TP15.TP
TX_MISO: IC6.6 (A5), IC7.9 (MISO), TP12.TP
TX_MOSI: IC6.5 (A4), IC7.7 (MOSI), TP11.TP
TX_REG_EN: IC2.3 (EN), R4.1; also elsewhere on the board
TX_RST: IC3.16 (P1.2), IC6.4 (A3), IC7.2 (NRESET), R7.1, TP6.TP
WDT_ACK: IC3.13 (P1.5), IC6.3 (A2)
WDT_ERR: IC3.14 (P1.4), IC6.9 (A8)
WDT_PA_EN: IC3.2 (P1.0), IC77.2 (B), R28.2, TP14.TP

Notes on the sheet:
spec inductors
<check
another one of these for a saw
mcl lha1+
make consistant
5p1
150n
82n
12p
green: 144 MHz
56n
56p
39p
2p2
6p2
15n
43n
22n
dnp
green: 434 MHz
monitor RX too, to see if packet hasnt been acked?
<< WHICH 5V?
ADD FILTER ON RST

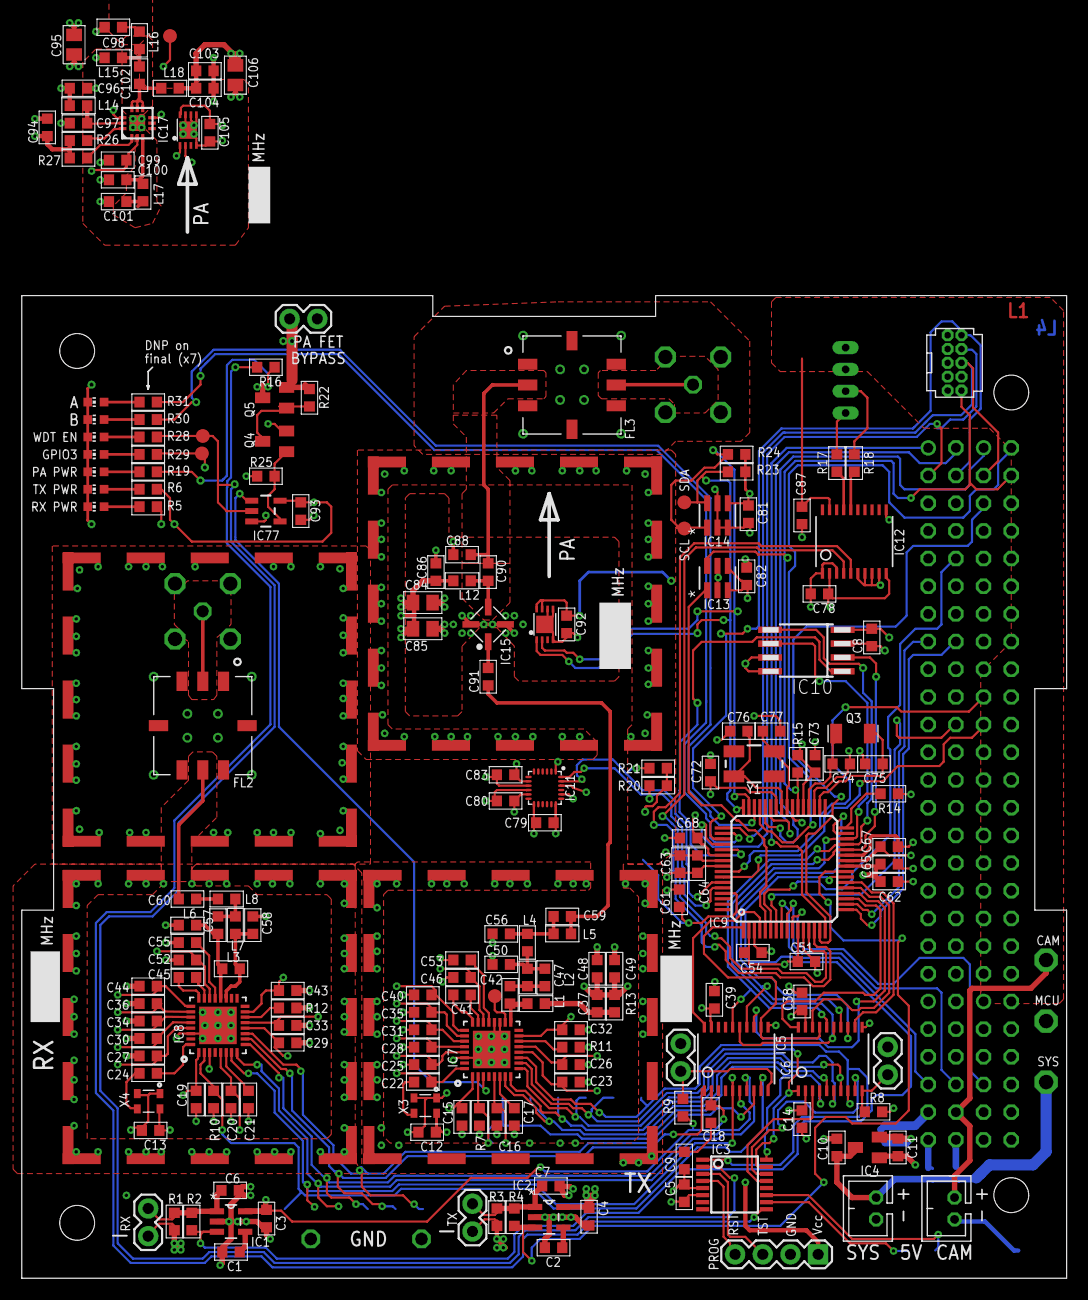
[picture p13: board fc-comms-2.brd from above]

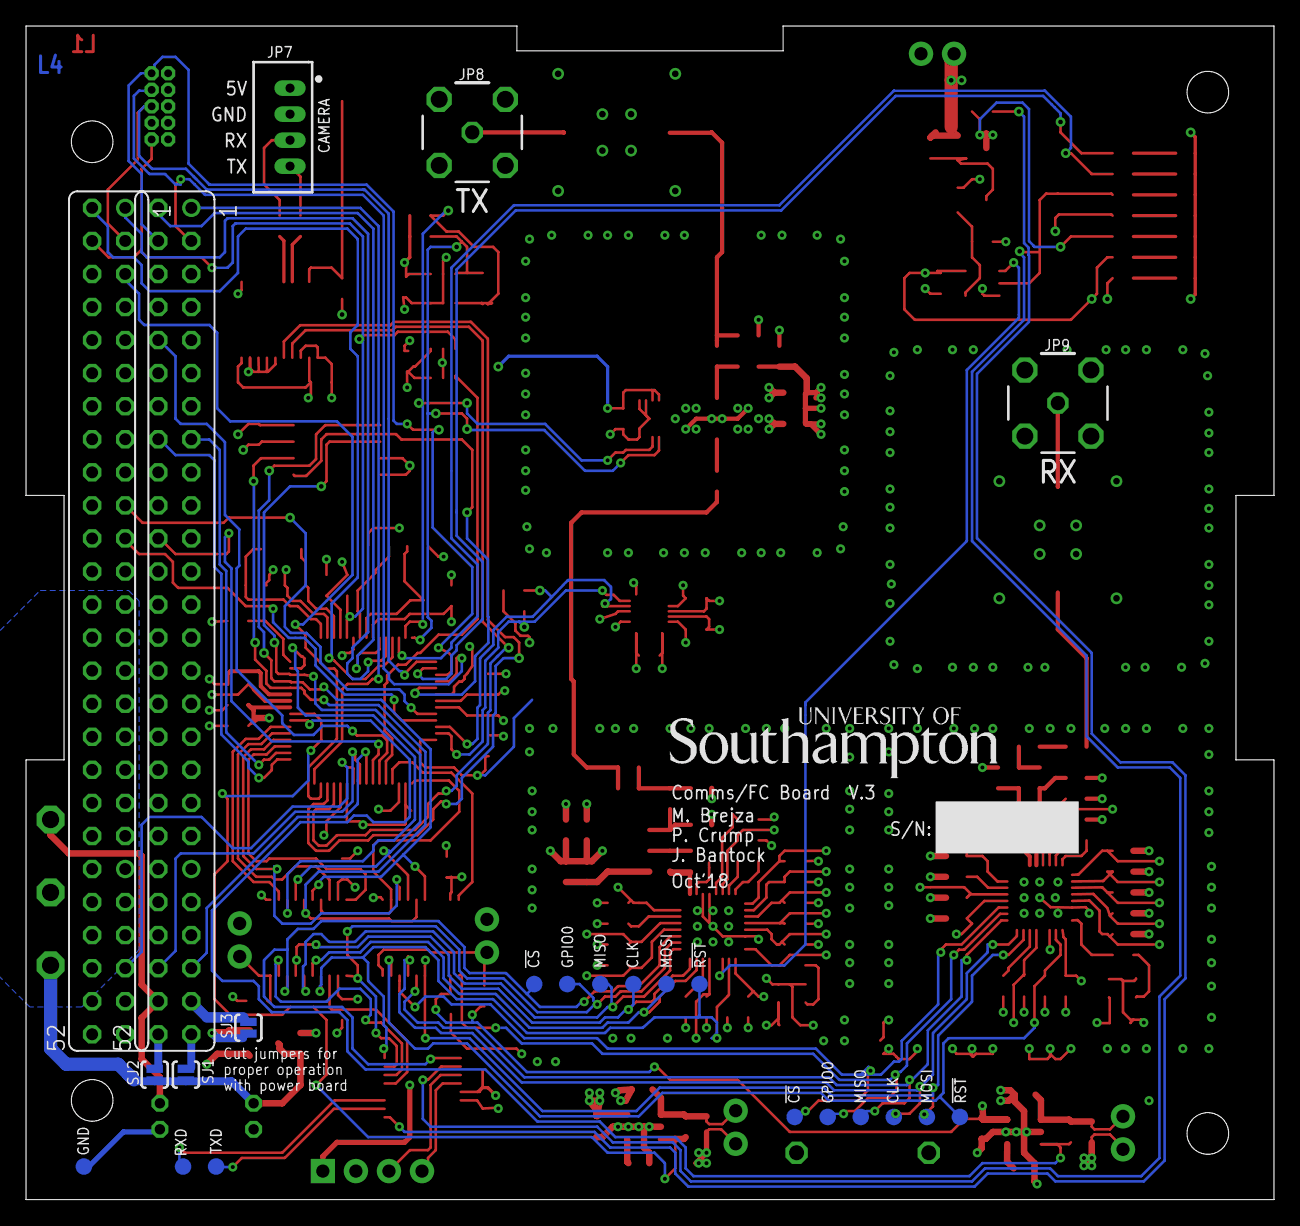
[picture p14: board fc-comms-2.brd from below]

Board: 4 copper layers, 95.9 x 90.2 mm, 228 parts (24 on the bottom side), 138 nets.

Other parts of the board:
U$1: OUTLINE
U$2: UOS_LOGO_SML
