mattbrejza/cubesat-comms/balun/Balun_Board_mb.brd

## EAGLE design balun/Balun_Board_mb.brd (2018-07-25)

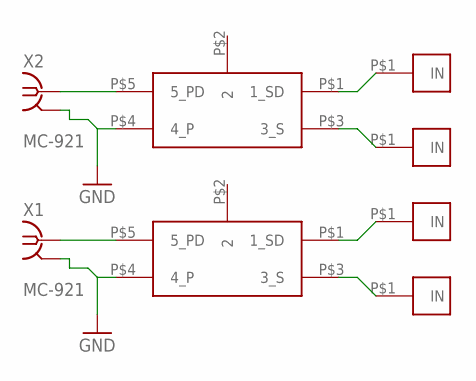
[picture p15: schematic Balun_Board_mb.sch]

Parts:
U$1, U$2: MABA-007159-000000
U$5, U$6, U$7, U$8: SMD-WIRE
X1, X2: MC-921

Connections:
GND: U$1.P$4 (4_P), U$2.P$4 (4_P), X1.2@1 (GND), X1.2@2 (GND), X2.2@1 (GND), X2.2@2 (GND)
unnamed: U$1.P$5 (5_PD), X2.1
unnamed: U$2.P$5 (5_PD), X1.1
unnamed: U$2.P$1 (1_SD), U$7.P$1
unnamed: U$2.P$3 (3_S), U$8.P$1
unnamed: U$1.P$1 (1_SD), U$5.P$1
unnamed: U$1.P$3 (3_S), U$6.P$1

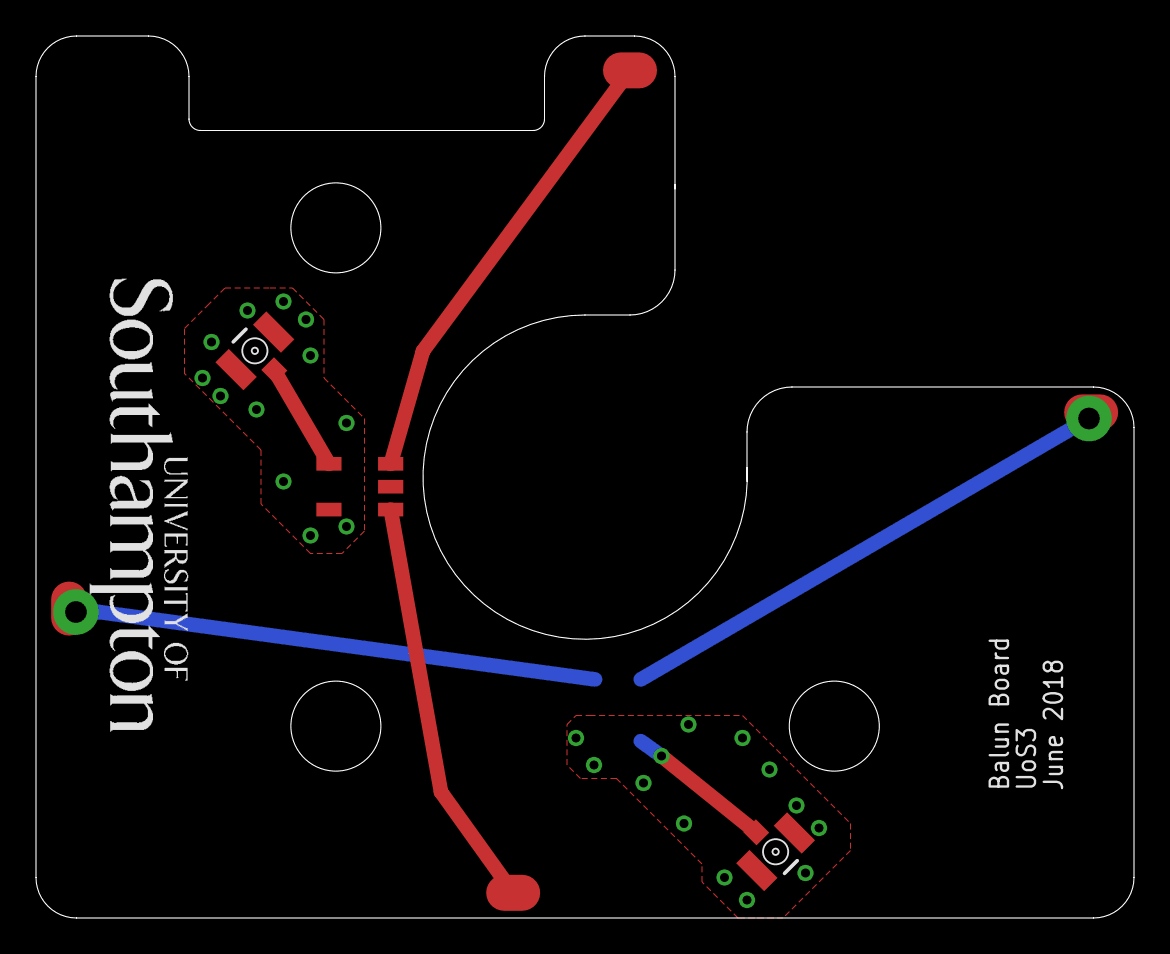
[picture p16: board Balun_Board_mb.brd from above]

Board: 2 copper layers, 61.0 x 49.0 mm, 9 parts (1 on the bottom side), 7 nets.

Other parts of the board:
U$3: UOS_LOGO_SML
