mattbrejza/cubesat-comms/board-cube/board-cube.brd

## EAGLE design board-cube/board-cube.brd (2016-11-07)

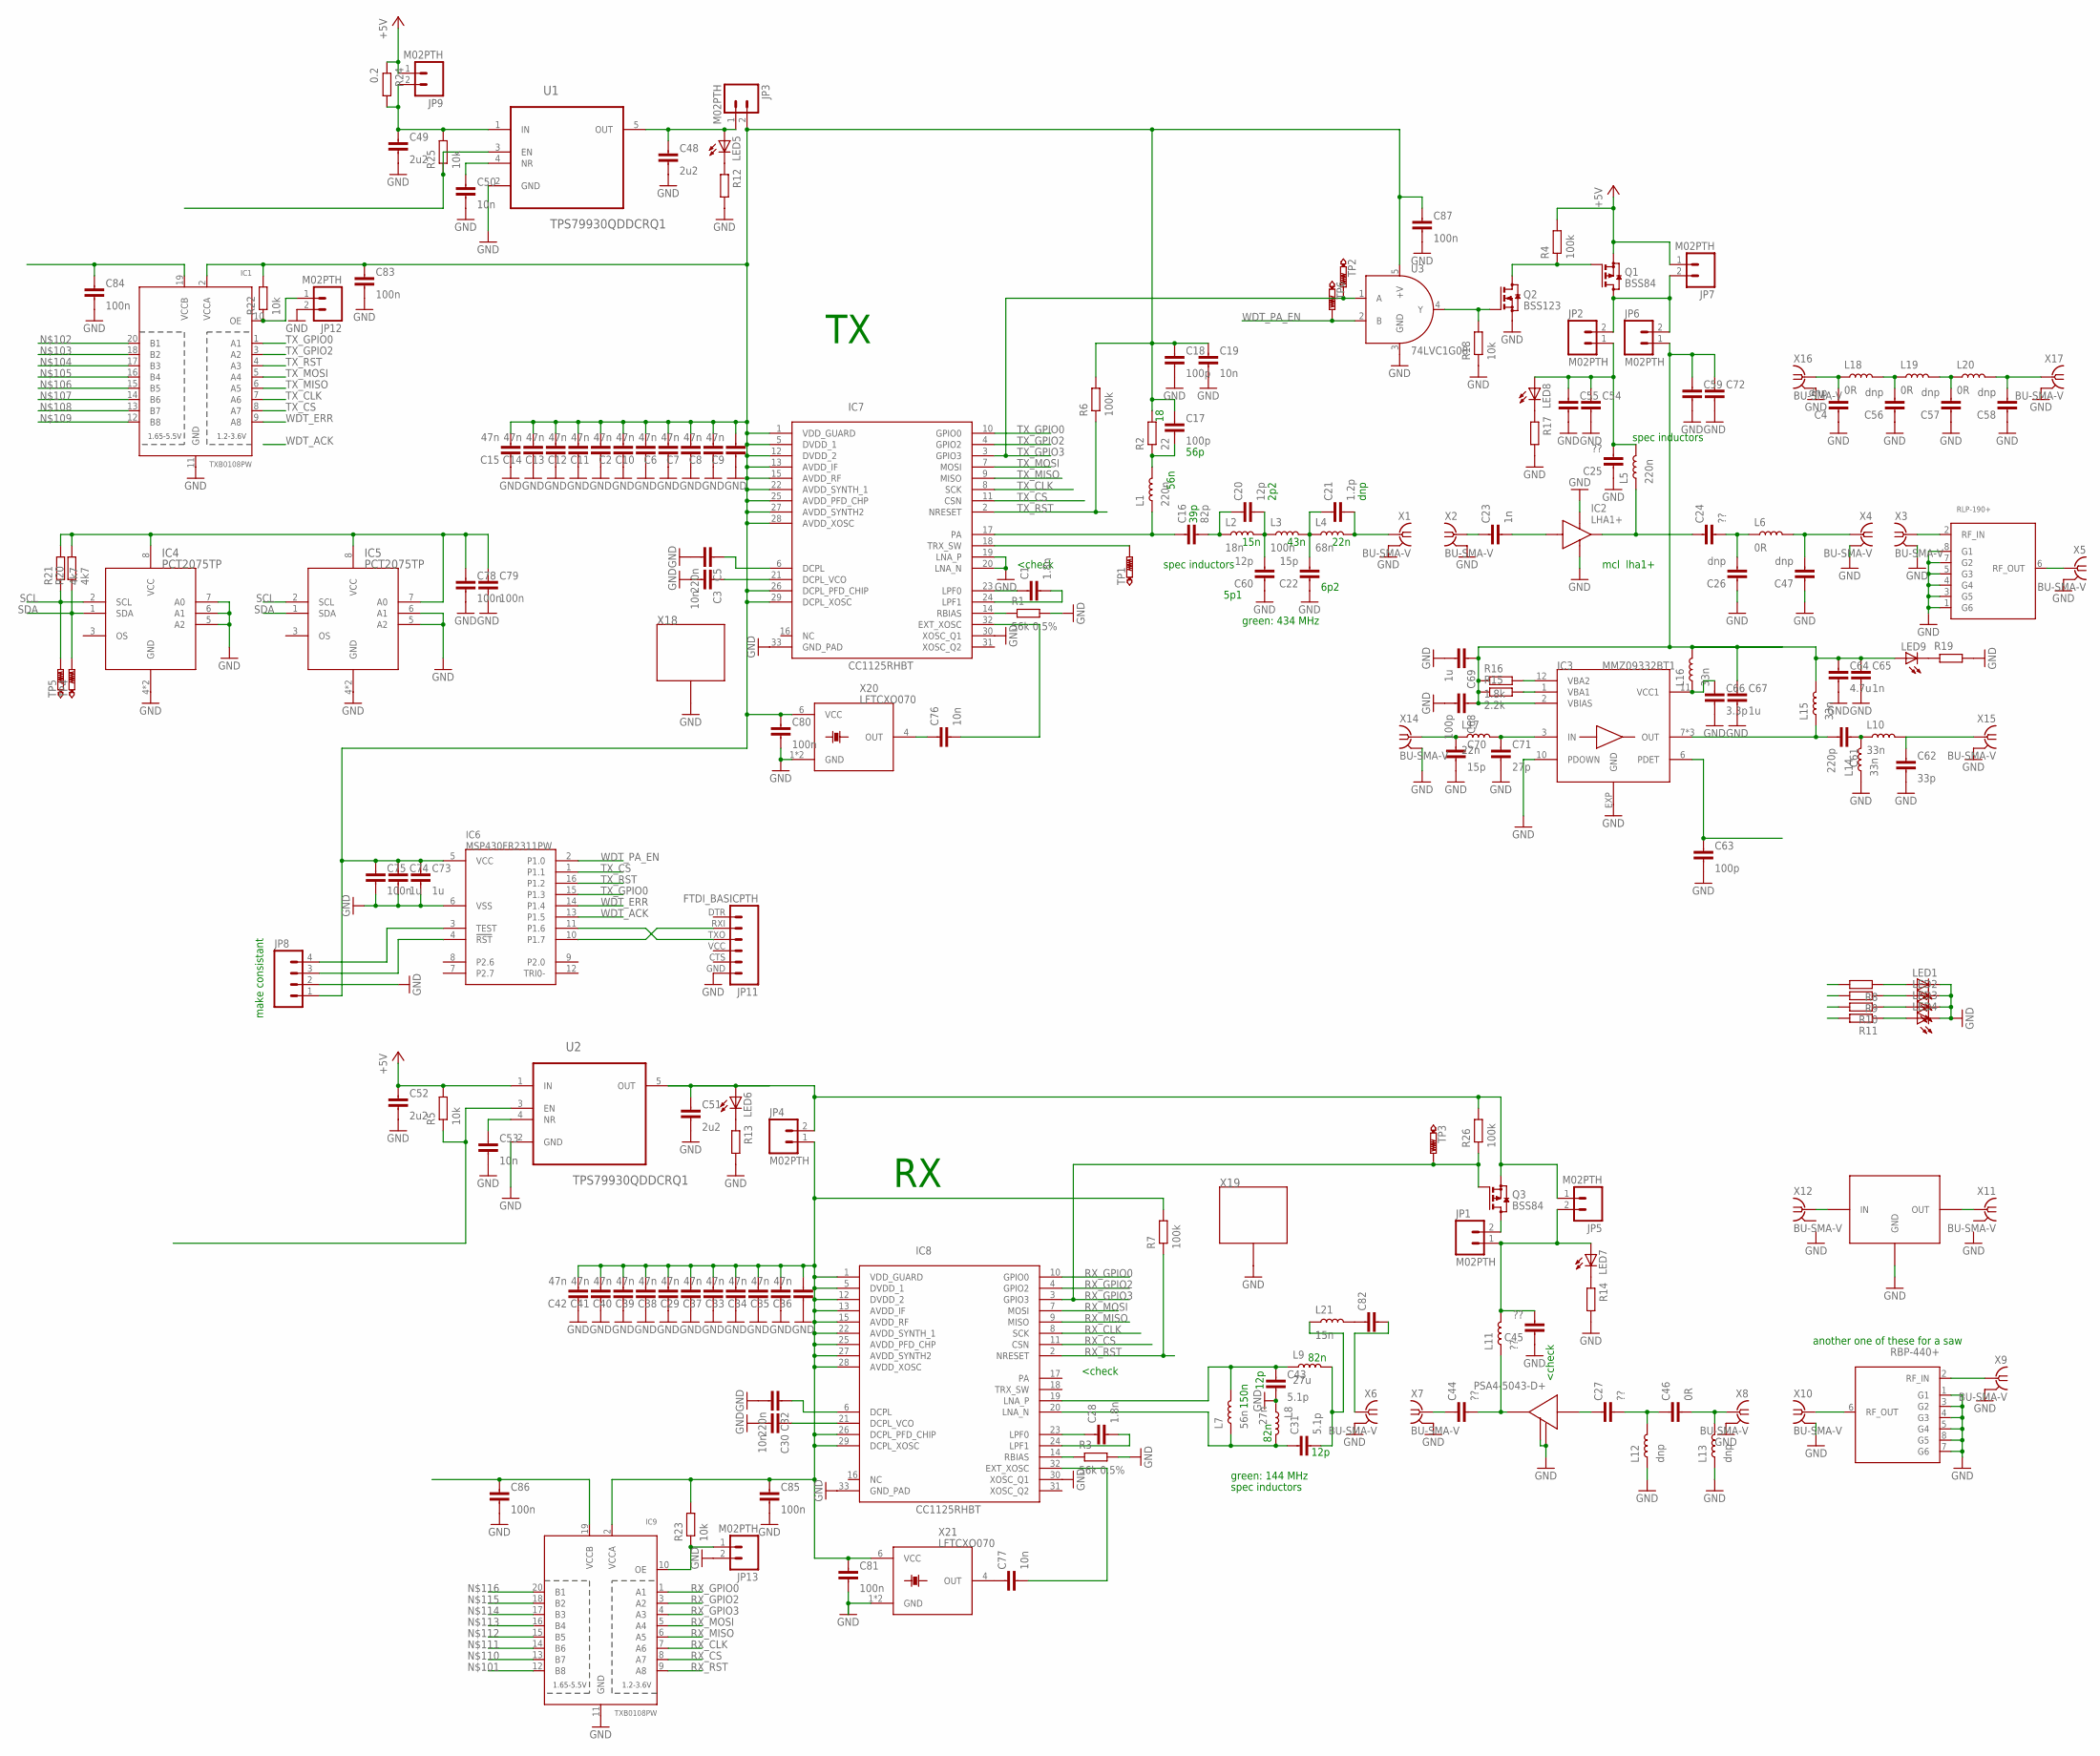
[picture p17: schematic board-cube.sch]

Parts:
C1, C28: 1.8n; C0603-N
C2, C6, C7, C8, C9, C10, C11, C12, C13, C14, C15, C29, C33, C34, C35, C36, C37, C38, C39, C40, C41, C42: 47n; C0603-N
C3, C19, C30, C50, C53, C76, C77: 10n; C0603-N
C4, C26, C47, C56, C57, C58: dnp; C0603-N
C5, C32: 220n; C0603-N
C16: 82p; C0603-N
C17, C18, C63, C68: 100p; C0603-N
C20, C60: 12p; C0603-N
C21: 1.2p; C0603-N
C22, C70: 15p; C0603-N
C23, C65: 1n; C0603-N
C24, C25, C27, C44, C45: ??; C0603-N
C31, C43: 5.1p; C0603-N
C46: 0R; C0603-N
C48, C49, C51, C52: 2u2; C0603-N
C54, C55, C59, C72: CAPACITOR0805-N; C0805-N
C61: 220p; C0603-N
C62: 33p; C0603-N
C64: 4.7u; C0603-N
C66: 3.3p; C0603-N
C67, C69, C73, C74: 1u; C0603-N
C71: 27p; C0603-N
C75, C78, C79, C80, C81, C83, C84, C85, C86, C87: 100n; C0603-N
C82: CAPACITOR0603-N; C0603-N
FL1: LPF_CS; PL-176
FL2: SAW_FILTER_CS; PL-176
FL3: GOLLEDGE_SAW_FILTER; GOLLEDGE_SAW
IC1, IC9: TXB0108PW; TSSOP20
IC2: LHA1+; PA
IC3: MMZ09332BT1; QFN3X3-6
IC4, IC5: PCT2075TP; HWSON8
IC6: MSP430FR2311PW; SSOP16
IC7, IC8: CC1125RHBT; QFN32_5X5
IC10: LNA_COMMON; LNA_MMM1362
JP1, JP2, JP3, JP4, JP5, JP6, JP7, JP9, JP12, JP13: M02PTH; 1X02
JP8: M04PTH; 1X04
JP11: FTDI_BASICPTH; FTDI_BASIC
L1, L5: 220n; L0603-N
L2: 18n; L0603-N
L3: 100n; L0603-N
L4: 68n; L0603-N
L6, L18, L19, L20: 0R; L0603-N
L7: 56n; L0603-N
L8: 27n; L0603-N
L9: 27u; L0603-N
L10, L14, L15, L16: 33n; L0603-N
L11: ??; L0603-N
L12, L13: dnp; L0603-N
L17: 22n; L0603-N
L21: 15n; L0603-N
LED1, LED2, LED3, LED4, LED5, LED6, LED7, LED8, LED9: LEDCHIP-LED0603; CHIP-LED0603
Q1, Q3: BSS84; SOT23
Q2: BSS123; SOT23
R1, R3: 56k 0.5%; R0603-N
R2: 22; R0603-N
R4, R6, R7, R26: 100k; R0603-N
R5, R18, R22, R23, R25: 10k; R0603-N
R8, R9, R10, R11, R12, R13, R14, R17, R19: RESISTOR0603-N; R0603-N
R15: 2.2k; R0603-N
R16: 1.8k; R0603-N
R20, R21: 4k7; R0603-N
R24: 0.2; R0603-N
TP1, TP2, TP3, TP4, TP5, TP6: PTR1B1,27; B1,27
U1, U2: TPS79930QDDCRQ1; SOT95P280X110-5N
U3: 74LVC1G08; SOT23-5
X1, X2, X3, X4, X5, X6, X7, X8, X9, X10, X11, X12, X14, X15, X16, X17: BU-SMA-V
X18, X19: SHIELD-26X26
X20, X21: LFTCXO070; 260-SERIES

Connections:
+5V: C52.1, JP7.1, JP9.1, Q1.2 (S), R4.2, R5.2, R24.1, U2.1 (IN)
GND: C2.1, C3.2, C4.1, C5.2, C6.1, C7.1, C8.1, C9.1, C10.1, C11.1, C12.1, C13.1, C14.1, C15.1, C18.2, C19.2, C22.1, C25.1, C26.1, C29.1, C30.2, C32.2, C33.1, C34.1, C35.1, C36.1, C37.1, C38.1, C39.1, C40.1, C41.1, C42.1, C43.2, C45.1, C47.1, C48.2, C49.2, C50.2, C51.2, C52.2, C53.2, C54.2, C55.2, C56.1, C57.1, C58.1, C59.2, C60.1, C62.2, C63.2, C64.2, C65.2, C66.2, C67.2, C68.2, C69.2, C70.2, C71.2, C72.2, C73.2, C74.2, C75.2, C78.2, C79.2, C80.2, C81.2, C83.2, C84.2, C85.2, C86.2, C87.2, FL1.1 (G6), FL1.3 (G5), FL1.4 (G4), FL1.5 (G3), FL1.7 (G2), FL1.8 (G1), FL2.1 (G1), FL2.3 (G2), FL2.4 (G3), FL2.5 (G4), FL2.7 (G6), FL2.8 (G5), FL3.A (GND), FL3.C (GND), FL3.D (GND), FL3.F (GND), IC1.11 (GND), IC2.GND1, IC2.GND2, IC3.10 (PDOWN), IC3.EXP (GND), IC4.4 (GND), IC4.5 (A2), IC4.6 (A1), IC4.7 (A0), IC4.EP (GND), IC5.4 (GND), IC5.5 (A2), IC5.6 (A1), IC5.EP (GND), IC6.6 (VSS), IC7.19 (LNA_P), IC7.20 (LNA_N), IC7.30 (XOSC_Q1), IC7.33 (GND_PAD), IC8.30 (XOSC_Q1), IC8.33 (GND_PAD), IC9.11 (GND), IC10.2, IC10.4, JP8.2, JP11.GND (6), JP12.2, JP13.2, L8.1, L12.1, L13.1, L14.1, LED1.C, LED2.C, LED3.C, LED4.C, Q2.2 (S), R1.2, R3.2, R12.2, R13.2, R14.2, R17.2, R18.1, R19.2, U1.2 (GND), U2.2 (GND), U3.3 (GND), X1.2, X1.3 (2), X1.4 (2), X1.5 (2), X2.2, X2.3 (2), X2.4 (2), X2.5 (2), X3.2, X3.3 (2), X3.4 (2), X3.5 (2), X4.2, X4.3 (2), X4.4 (2), X4.5 (2), X5.2, X5.3 (2), X5.4 (2), X5.5 (2), X6.2, X6.3 (2), X6.4 (2), X6.5 (2), X7.2, X7.3 (2), X7.4 (2), X7.5 (2), X8.2, X8.3 (2), X8.4 (2), X8.5 (2), X9.2, X9.3 (2), X9.4 (2), X9.5 (2), X10.2, X10.3 (2), X10.4 (2), X10.5 (2), X14.2, X14.3 (2), X14.4 (2), X14.5 (2), X15.2, X15.3 (2), X15.4 (2), X15.5 (2), X16.2, X16.3 (2), X16.4 (2), X16.5 (2), X17.2, X17.3 (2), X17.4 (2), X17.5 (2), X18.G1, X18.G2, X18.G3, X18.G4, X18.G5, X18.G6, X18.G7, X18.G8, X18.G9, X18.G10, X18.G11, X18.G12, X18.G13, X18.G14, X18.G15, X18.G16, X18.G17, X18.G19, X18.G20, X18.G21, X19.G1, X19.G2, X19.G3, X19.G4, X19.G5, X19.G6, X19.G7, X19.G8, X19.G9, X19.G10, X19.G11, X19.G12, X19.G13, X19.G14, X19.G15, X19.G16, X19.G17, X19.G19, X19.G20, X19.G21, X20.1 (GND), X20.3 (GND), X21.1 (GND), X21.3 (GND)
unnamed: C1.1, IC7.23 (LPF0)
unnamed: C1.2, IC7.24 (LPF1)
unnamed: C23.2, IC2.RF_IN
unnamed: C3.1, IC7.21 (DCPL_VCO)
unnamed: C17.2, L1.2, R2.1
unnamed: JP2.2, JP6.2, JP7.2, Q1.3 (D)
unnamed: C16.1, IC7.17 (PA), L1.1
unnamed: IC7.14 (RBIAS), R1.1
unnamed: C76.2, IC7.32 (EXT_XOSC)
unnamed: LED1.A, R8.1
unnamed: LED2.A, R9.1
unnamed: LED3.A, R10.1
unnamed: IC7.18 (TRX_SW), TP1.TP
unnamed: LED4.A, R11.1
unnamed: C4.2, L18.1, X16.1
unnamed: C24.1, IC2.RF_OUT, L5.1
unnamed: C5.1, IC7.6 (DCPL)
unnamed: C16.2, C20.1, L2.1
unnamed: C20.2, C60.2, L2.2, L3.1
unnamed: C21.1, C22.2, L3.2, L4.1
unnamed: C21.2, L4.2, X1.1
unnamed: C59.1, C64.1, C65.1, C67.1, C68.1, C69.1, C72.1, IC3.2 (VBIAS), JP6.1, L15.2, L16.2, LED9.A, R15.1, R16.1
unnamed: C24.2, C26.2, L6.1
unnamed: C23.1, X2.1
unnamed: C47.2, L6.2, X4.1
unnamed: FL1.2 (RF_IN), X3.1
unnamed: FL1.6 (RF_OUT), X5.1
unnamed: C28.1, IC8.23 (LPF0)
unnamed: C28.2, IC8.24 (LPF1)
unnamed: C30.1, IC8.21 (DCPL_VCO)
unnamed: C44.1, X7.1
unnamed: C44.2, IC10.1 (RF_OUT), L11.1
unnamed: IC8.14 (RBIAS), R3.1
unnamed: C77.2, IC8.32 (EXT_XOSC)
unnamed: C48.1, JP3.1, LED5.A, U1.5 (OUT)
unnamed: LED5.C, R12.1
unnamed: LED6.C, R13.1
unnamed: LED7.C, R14.1
unnamed: FL3.E (OUT), X11.1
unnamed: FL3.B (IN), X12.1
unnamed: C32.1, IC8.6 (DCPL)
unnamed: C27.1, IC10.3 (RF_IN)
unnamed: C43.1, IC8.19 (LNA_P), L7.2, L9.1
unnamed: C31.1, IC8.20 (LNA_N), L7.1, L8.2
unnamed: C82.2, X6.1
unnamed: C27.2, C46.1, L12.2
unnamed: C2.2, C6.2, C7.2, C8.2, C9.2, C10.2, C11.2, C12.2, C13.2, C14.2, C15.2, C17.1, C18.1, C19.1, C73.1, C74.1, C75.1, C80.1, C83.1, C87.1, IC1.2 (VCCA), IC6.5 (VCC), IC7.1 (VDD_GUARD), IC7.5 (DVDD_1), IC7.12 (DVDD_2), IC7.13 (AVDD_IF), IC7.15 (AVDD_RF), IC7.22 (AVDD_SYNTH_1), IC7.25 (AVDD_PFD_CHP), IC7.26 (DCPL_PFD_CHIP), IC7.27 (AVDD_SYNTH2), IC7.28 (AVDD_XOSC), IC7.29 (DCPL_XOSC), JP3.2, JP8.1, R2.2, R6.2, R22.2, U3.5 (+V), X20.6 (VCC)
unnamed: C45.2, JP1.1, JP5.2, L11.2, LED7.A
unnamed: JP4.2, JP5.1, LED6.A, Q3.2 (S), R26.2
unnamed: C46.2, L13.2, X8.1
unnamed: FL2.2 (RF_IN), X9.1
unnamed: FL2.6 (RF_OUT), X10.1
unnamed: C50.1, U1.4 (NR)
unnamed: C61.1, L10.1, L14.2
unnamed: C51.1, U2.5 (OUT)
unnamed: C53.1, U2.4 (NR)
unnamed: R5.1, U2.3 (EN)
unnamed: Q1.1 (G), Q2.3 (D), R4.1
unnamed: C29.2, C33.2, C34.2, C35.2, C36.2, C37.2, C38.2, C39.2, C40.2, C41.2, C42.2, C81.1, C85.1, IC8.1 (VDD_GUARD), IC8.5 (DVDD_1), IC8.12 (DVDD_2), IC8.13 (AVDD_IF), IC8.15 (AVDD_RF), IC8.22 (AVDD_SYNTH_1), IC8.25 (AVDD_PFD_CHP), IC8.26 (DCPL_PFD_CHIP), IC8.27 (AVDD_SYNTH2), IC8.28 (AVDD_XOSC), IC8.29 (DCPL_XOSC), IC9.2 (VCCA), JP4.1, R7.2, R23.2, X21.6 (VCC)
unnamed: C61.2, IC3.7 (OUT), IC3.8 (OUT), IC3.9 (OUT), L15.1
unnamed: C62.1, L10.2, X15.1
unnamed: C63.1, IC3.6 (PDET)
unnamed: LED8.C, R17.1
unnamed: C66.1, IC3.11 (VCC1), L16.1
unnamed: C49.1, JP9.2, R24.2, R25.2, U1.1 (IN)
unnamed: IC3.12 (VBA2), R16.2
unnamed: IC3.1 (VBA1), R15.2
unnamed: LED9.C, R19.1
unnamed: C70.1, L17.1, X14.1
unnamed: C71.1, IC3.3 (IN), L17.2
unnamed: JP1.2, Q3.3 (D)
unnamed: C56.2, L18.2, L19.1
unnamed: C57.2, L19.2, L20.1
unnamed: C58.2, L20.2, X17.1
unnamed: C25.2, C54.1, C55.1, JP2.1, L5.2, LED8.A
unnamed: IC1.10 (OE), JP12.1, R22.1
unnamed: C76.1, X20.4 (OUT)
unnamed: C77.1, X21.4 (OUT)
unnamed: IC6.3 (TEST), JP8.4
unnamed: IC6.4 (!RST), JP8.3
unnamed: IC6.11 (P1.6), JP11.TXO (3)
unnamed: C78.1, C79.1, IC4.8 (VCC), IC5.7 (A0), IC5.8 (VCC), R20.2, R21.2
unnamed: IC6.10 (P1.7), JP11.RXI (2)
unnamed: C82.1, L21.2
unnamed: C31.2, L9.2, L21.1
unnamed: IC9.10 (OE), JP13.1, R23.1
unnamed: C84.1, IC1.19 (VCCB)
unnamed: C86.1, IC9.19 (VCCB)
unnamed: R25.1, U1.3 (EN)
unnamed: Q2.1 (G), R18.2, U3.4 (Y)
RX_CLK: IC8.8 (SCK), IC9.7 (A6)
RX_CS: IC8.11 (CSN), IC9.8 (A7)
RX_GPIO0: IC8.10 (GPIO0), IC9.1 (A1)
RX_GPIO2: IC8.4 (GPIO2), IC9.3 (A2)
RX_GPIO3: IC8.3 (GPIO3), IC9.4 (A3), Q3.1 (G), R26.1, TP3.TP
RX_MISO: IC8.9 (MISO), IC9.6 (A5)
RX_MOSI: IC8.7 (MOSI), IC9.5 (A4)
RX_RST: IC8.2 (NRESET), IC9.9 (A8), R7.1
SCL: IC4.2 (SCL), IC5.2 (SCL), R21.1, TP5.TP
SDA: IC4.1 (SDA), IC5.1 (SDA), R20.1, TP4.TP
TX_CLK: IC1.7 (A6), IC7.8 (SCK)
TX_CS: IC1.8 (A7), IC6.1 (P1.1), IC7.11 (CSN)
TX_GPIO0: IC1.1 (A1), IC6.15 (P1.3), IC7.10 (GPIO0)
TX_GPIO2: IC1.3 (A2), IC7.4 (GPIO2)
TX_GPIO3: IC7.3 (GPIO3), TP2.TP, U3.1 (A)
TX_MISO: IC1.6 (A5), IC7.9 (MISO)
TX_MOSI: IC1.5 (A4), IC7.7 (MOSI)
TX_RST: IC1.4 (A3), IC6.16 (P1.2), IC7.2 (NRESET), R6.1
WDT_ACK: IC6.13 (P1.5)
WDT_ERR: IC1.9 (A8), IC6.14 (P1.4)
WDT_PA_EN: IC6.2 (P1.0), TP6.TP, U3.2 (B)

Notes on the sheet:
spec inductors
<check
another one of these for a saw
mcl lha1+
make consistant
5p1
150n
82n
12p
green: 144 MHz
56n
56p
39p
2p2
6p2
15n
43n
22n
dnp
green: 434 MHz

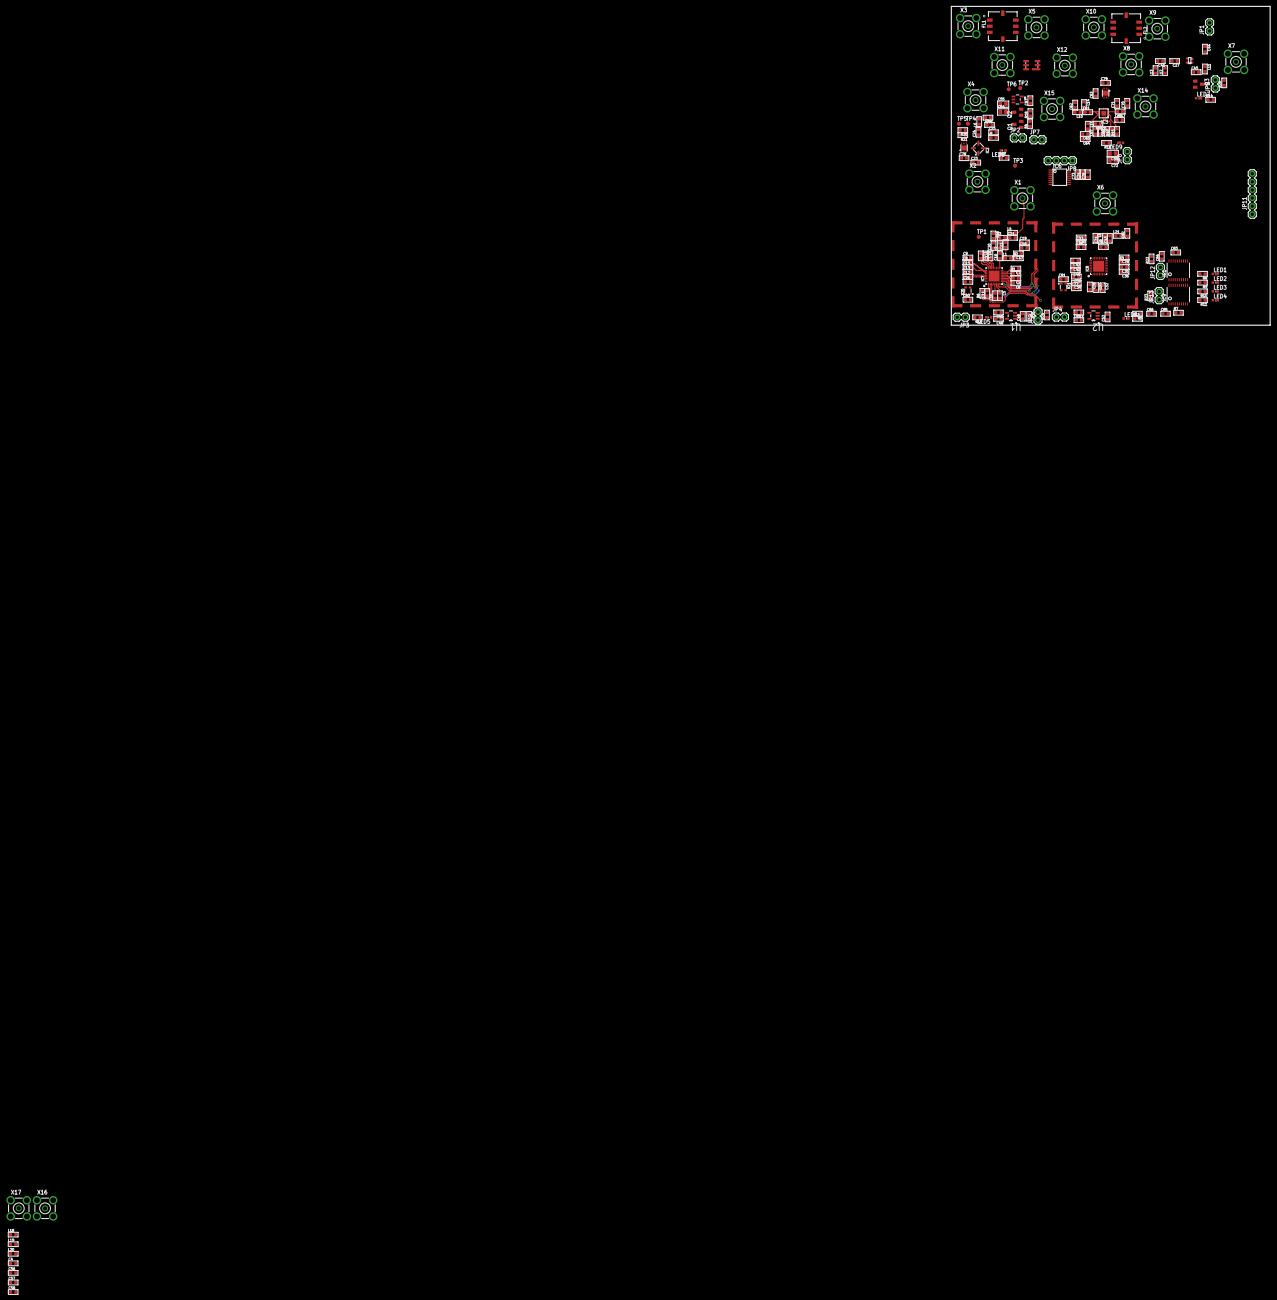
[picture p18: board board-cube.brd from above]

Board: 4 copper layers, 100.0 x 100.0 mm, 200 parts (0 on the bottom side), 112 nets.
