mattbrejza/cubesat-comms/(commit log)

2016-03-22 more work
    [board-cube.brd, board-cube.sch]
2016-03-23 enabling 4 layer
    [board-cube.brd]
2016-06-08 Add Ava.lbr submodule for 434MHz SAW footprint.
2016-06-08 Add 434MHz SAW and 2x SMA Connectors to sch,lbr.
    [board-cube.brd, board-cube.sch]
2016-10-23 added alternate PA
    [board-cube.brd, board-cube.sch]
2016-10-23 adding supervising processor
    [board-cube.brd, board-cube.sch]
2016-10-23 rough placement of PA
    [board-cube.brd]
2016-10-25 fixing filter pin 1 dot
2016-10-25 updated footprints from modified library
    [board-cube.brd, board-cube.sch]
2016-10-26 adding tcxo and temp sensor
    [board-cube.brd, board-cube.sch]
2016-10-27 updating footprints and values, changing msp watchdog part
    [board-cube.brd, board-cube.sch]
2016-10-31 added level shifter
    [board-cube.brd, board-cube.sch]
2016-11-01 Fix PSA5043 LNA footprint.
    [board-cube.brd, board-cube.sch]
2016-11-04 moving things around to fit better
    [board-cube.brd]
2016-11-05 most digital signals wired up
    [board-cube.brd, board-cube.sch]
2016-11-07 moving some parts around
    [board-cube.brd]
2016-12-12 added merged board
    [fc-comms.brd, fc-comms.sch]
2016-12-12 added outline and corrected header locations
    [fc-comms.brd, fc-comms.sch]
2016-12-12 more placement
    [fc-comms.brd, fc-comms.sch]
2016-12-17 add digital wired up
    [fc-comms.brd, fc-comms.sch]
2016-12-17 started routing
    [fc-comms.brd, fc-comms.sch]
2016-12-19 more routing
    [fc-comms.brd]
2016-12-29 some more routing
    [fc-comms.brd, fc-comms.sch]
2016-12-29 cleaning up silk
    [fc-comms.brd, fc-comms.sch]
2016-12-29 almost done
    [fc-comms.brd, fc-comms.sch]
2017-01-12 fixing resist issue on the m4
    [fc-comms.brd, fc-comms.sch]
2017-01-21 adjusted crystal footprints
    [fc-comms.brd, fc-comms.sch]
2017-03-15 sent off
    [fc-comms.brd, fc-comms.sch]
2018-06-30 finishing off balun obard
    [Balun_Board_mb.brd, Balun_Board_mb.sch]
2018-07-24 starting v2 of the board
    [fc-comms-2.brd, fc-comms-2.sch]
2018-10-14 adding fram, some routing
    [fc-comms-2.brd, fc-comms-2.sch]
2018-10-14 most routing done, still some queries remain
    [fc-comms-2.brd, fc-comms-2.sch]
2018-10-21 added camera header, RF connectors, some cleanup
    [fc-comms-2.brd, fc-comms-2.sch]
2018-10-24 switching to lha1+, camera rx/tx done
    [fc-comms-2.brd, fc-comms-2.sch]
2018-11-06 adding gerbers
